Guitar-Sound-Processing/GSP/README.md

# <div align="center">[GSP](https://github.com/Guitar-Sound-Processing/GSP/wiki)</div>

## <div align="center">[Multi Effect Guitar Sound Processing](https://github.com/Guitar-Sound-Processing/GSP/wiki)</div>

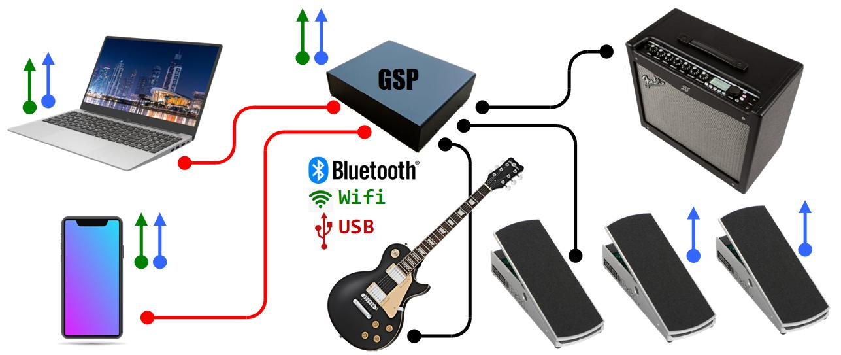
[picture p1: resources/gsp_periph.jpg]
GSP Peripherals
