Guitar-Sound-Processing/GSP/hardware/DriverBoard.md

# Driver Board

The Driver Board (DB) provides audio signal conditioning to the Analogue to Digital Convertion (ADC) of Daisy Seed board. Additionally DB perform filtering and amplification of Daisy's audio output that comes from Digital to Analogue Convertion (DAC). 
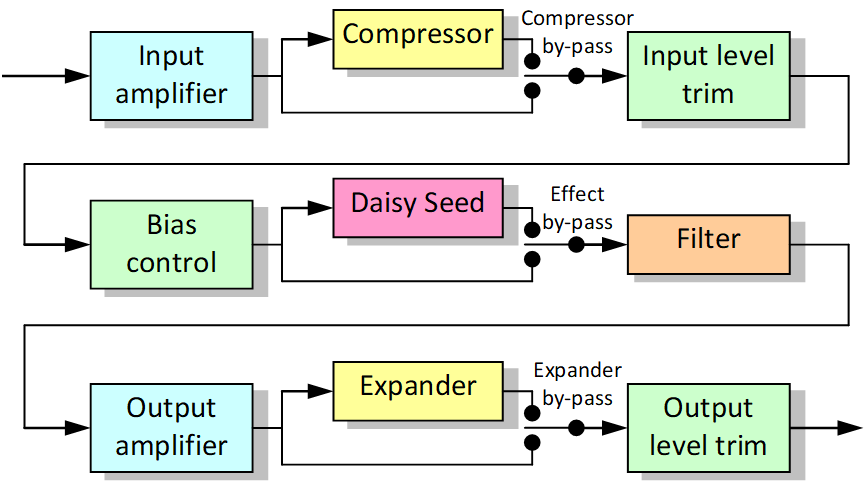
[picture p2: resources/driver_board_1.png]
Driver Board


The major components of the Driver Board are, as shown in the figure above:

- a quadruple operation amplifier LM324 for signal conditioning and amplification
- an analogue Compressor and Expander NE570
- 3 hadware switches to bypass the compressor, expander and Daisy Seed board
- 6 trimpot potentiometers to adjust the input level, Compressor output level, ADC input level, DAC output level, Expander output level, and GSP output level

The Driver Board has a quadruple operation amplifier LM324 to amplify the input signal from guitar at approximately 1V maximum amplitude up to 3.5V (biased at +4.5V) for compressor input, using the input level trimpot T1 (see figure below) measured at test point P1. A sine wave signal of 1V amplitude at 440 Hz can be used at input port to trim the potentiometers. The amplitude of the compressor output shall be adjusted by the Compressor output trimpot (T2) so as to have the same level of its input signal (3.5V) at test point P2. Then the signal is biased to +1.6V and to 1.6V amplitude (0 to 3.2V) at P3 using the ADC input trimpot (T3). After being digitally processed by the [Daisy Seed Shield](https://github.com/Guitar-Sound-Processing/GSP/blob/main/hardware/DS_board.md), the analogue signal returns to the Driver Board and pass to a second order low pass filter. It is then biased again to +4.5V and amplified to 3.5V at P4 by the DAC output trimmer (T4) before entering in to the Expander. The output amplitude of the Expander shall be adjusted by the Expander trimpot (T5) so as to be equal to its input level (3.5V) at P5. Finally the DC level is removed from the output signal and amplified by the output level trimpot (T6), just to have the same level of the guitar input signal (1V amplitude) at test point P6. The testing terminals P1...P6 shown in figure below shall be used to check the signal wave and to measure its amplitude. Picture below shows also the Compressor bypass switch (S1), Daisy Seed bypass (S2) and Expander bypass switch (S3)

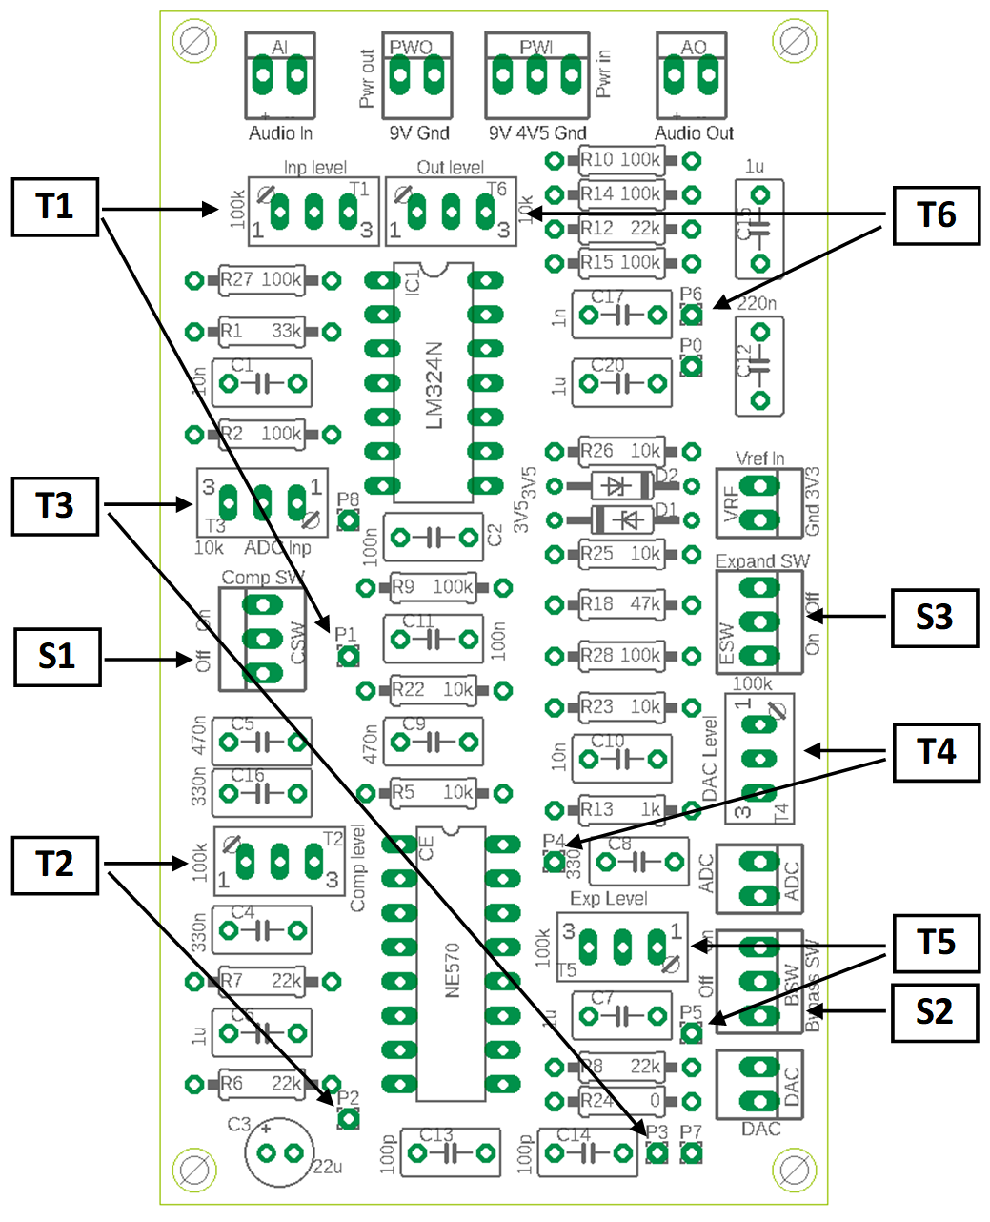
[picture p3: resources/driver_trim.png]
Driver Board PCB


DB was designed using the free version of Autodesk Eagle. Future versions will be based on Kicad. Moreover the board was conceived so as to avoid SMD components, to make it easy to populate by DIY users. The schematics and PCB layout are [available to download](https://github.com/Guitar-Sound-Processing/GSP/blob/main/resources/gsp_drv_v3.zip) as well as the board layout in Eagle files. For those that prefer Kicad instead of Eagle, is worth to mention that Kicad easily opens and converts Eagle files.

**Important notes:**

  1) Diodes D1 and D2 are protection diodes. They are NOT really required and can distort the audio signal. Please ignore these diodes unless you feel unsecured.
  2) Resistor R24 is just a jumper (0 Ohm). It gives more flexibility in case the output of the Expander does not reach the desired voltage.

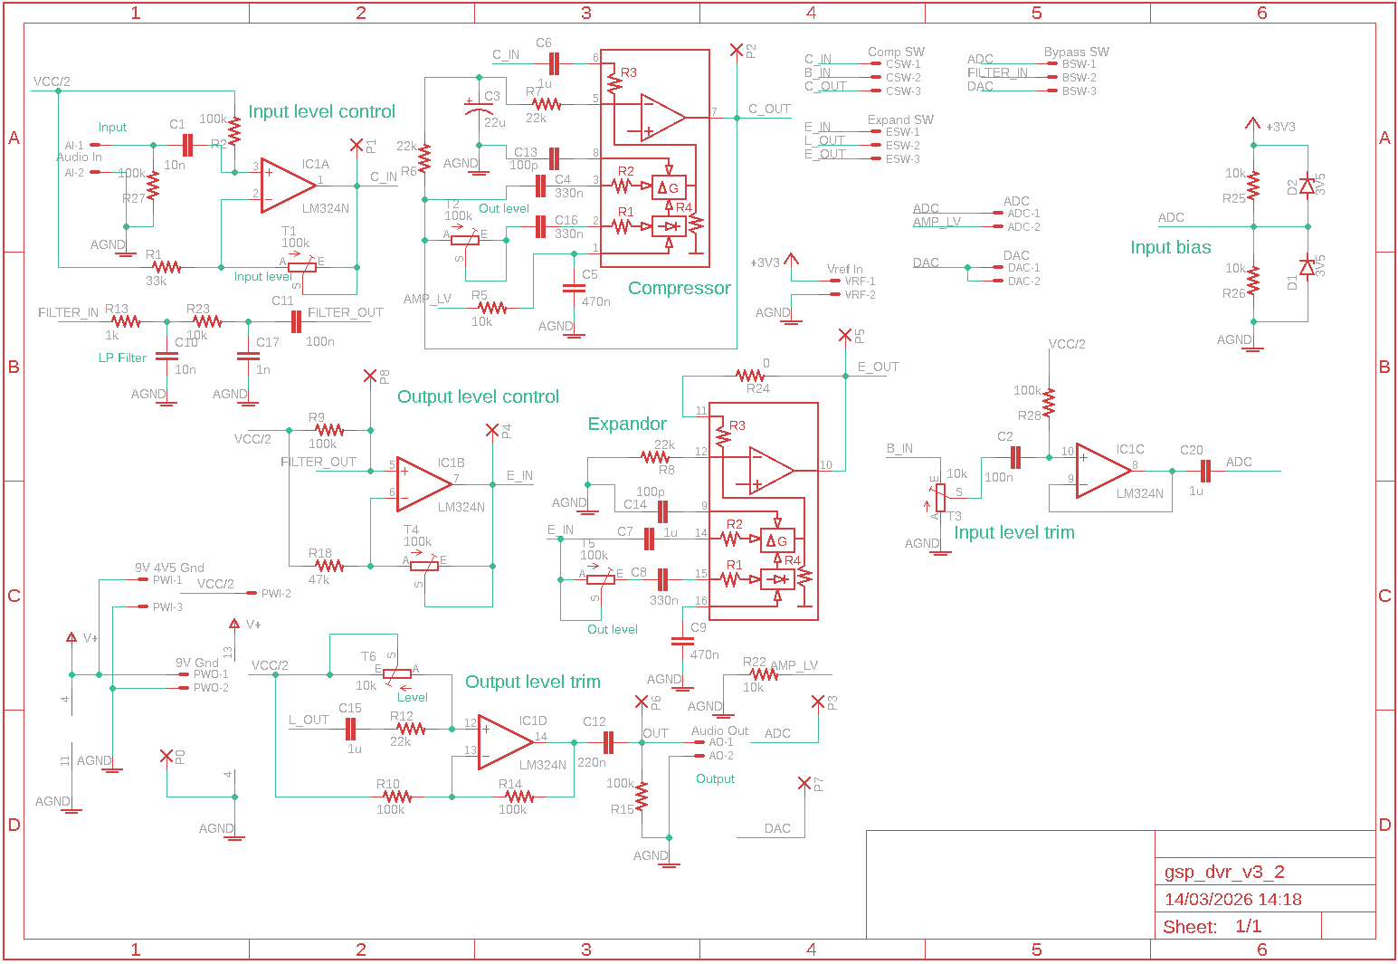
[picture p4: resources/driver_board_sch.png]
Driver Board SCH
