Guitar-Sound-Processing/GSP/hardware/ESP32_shield.md

# ESP32 Shield

The current version of GSP uses a ESP32 Wrover as External Device. To integrate the Wrover board to GSP, a dedicated pcb shield was designed to provide standard interfaces to Expression Pedals and Serial UART lines to Daisy Seed. Moreover, some jumpers are provided to interface the ESP32 Shield to a nRF24L01 wireless module for remote Expression Pedals. The Shield board does not contain any direct wiring to peripherics. All connections shall be manually provided by jumpers. This allow flexibility to change the Wrover (or any other compatible ESP32 board) pins to the desired data and power lines. The main characteristics of the board are:

- One JST PH header for 5V ESP32 input power line.
- Two 4 pin sockets to connect ESP32 to nRF24L01 module with air jumpers.
- A JST PH header for 3V3 and ground output to support magnetic isolator module
- Two JST PH 4 pin headers for Expression Pedal connection with Plug and Play capability.
- Two JST PH 2 pin headers to provide Serial lines to [Daisy Seed Shield](https://github.com/Guitar-Sound-Processing/GSP/blob/main/hardware/DS_board.md).
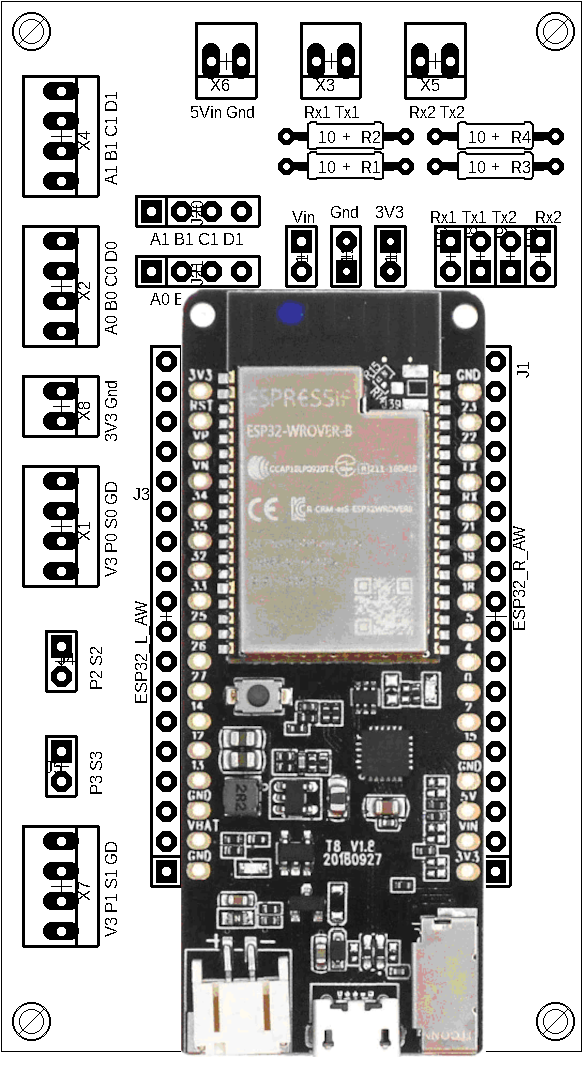
[picture p11: resources/ESP32_board.png]
ESP32 Board


Some of these connectors are already connected to the ESP32 pins, although they need jumpers to enable connection. They are:

 - Vin jumper connects the 5Vin (input power) to ESP32 VIN pin.
 - Gnd jumper joins the input ground from 5Vin input power to ESP32 Wrover ground pins, besides grounding both Expression Pedal headers and the ground pin of 3V3 output header.
 - 3V3 jumper enables the connection between the 3V3 output from ESP32 to the Expression Pedal headers and the 3V3 output connector for magnetic isolator module.
 - Tx1, Rx1, Tx2 and Rx2 jumpers to connect the JST headers for Serial lines to ESP32 pins: Tx1-GPIO23, Rx1-GPIO22, Tx2-GPIO19, Rx2-GPIO18.

In normal situation all these jumpers shall be wired. The ESP32 Wrover TIGO module has 34 pins (2x17). However the board has 36 (2x18) pins, as can be seen in figure above, since it is difficult to find female headers with 17 pins. So care must be taken in order to avoid placing the Wrover module in the wrong pins. 

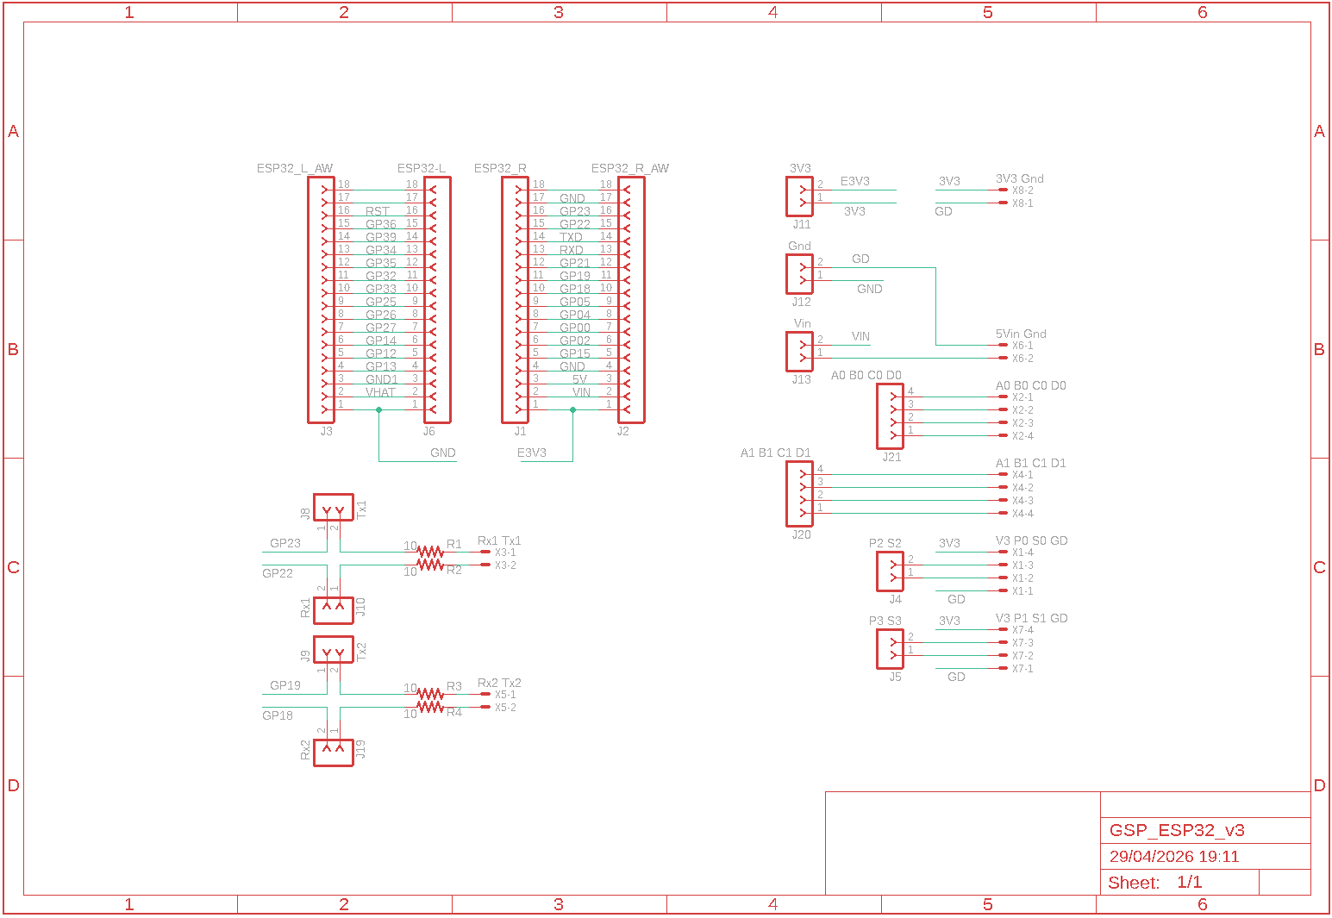
[picture p12: resources/ESP32_shield.png]
ESP32 Board schematics


The PCB was designed with Autodesk Eagle, but next version will be based on Kicad. The Eagle files for schematics and boards are available [here](https://raw.githubusercontent.com/Guitar-Sound-Processing/GSP/master/resources/ESP32_shield.zip).
