Guitar-Sound-Processing/GSP/hardware/GSP_boards.md

# GSP Boards

Current GSP version comprises four small pcb boards:

- [Daisy Seed Shield](https://github.com/Guitar-Sound-Processing/GSP/blob/main/hardware/DS_board.md)
- [Driver Board](https://github.com/Guitar-Sound-Processing/GSP/blob/main/hardware/DriverBoard.md)
- [ESP32 Shield](https://github.com/Guitar-Sound-Processing/GSP/blob/main/hardware/ESP32_shield.md)
- [Input and Output Board](https://github.com/Guitar-Sound-Processing/GSP/blob/main/hardware/IOBoard.md)

All boards have the same footprint, of 50 x 90 mm, which are cheaper to produce. They can be easily stacked, although they don't have stacking headers; only JST PH 2.0 Plug 2.0mm pitch headers to provide electrical interface between boards. They also have only pass through holes, without any SMD components (this may change in future versions).

The boards were designed with 1 mm width wiring, 2 layers (Bottom and Up) and no vias. That makes it easy to hand made all boards.

Daisy Seed Shield (DSS) provides a double header to stack the Daisy Seed board, besides a small DC/DC converter for 5V output to DS and ESP32 boards, together with JST headers for input and output audio signal.

The Audio Driver Board (ADB) amplifies the analogue input audio signal and compress it before delivering the signal to DSS. This board also filters and expand the analogue DSS output audio from DSS.

ESP32 Shield (ESPS) has a double header for ESP32 Wrover Lilygo TTGO board with SD Card support. It's main task is to provide high level user interface with DSS together with Expression Pedal interface. The board also provides a socket to a nRF24L01 board connection and JST headers to up to four Expression Pedals.

Finally the Input and Output Board (IOB) has 1/4 inch input and output guitar jacks, and one stereo jack for Expression Pedal.
