Guitar-Sound-Processing/GSP/gsp_daisy/Effects.md

# Effect Commands

Effect Commands are the way GSP uses to change the configuration parameters of any effect.

## Effect Command format

Any Effect Command must obey the following format:

*efc* [([+][-]*c*)] […[[[[*s*] *p*<sub>1</sub>] *p*<sub>2</sub>] *p*<sub>3</sub>]…]

in which:

-	*efc* stands for the three-characters effect name, like ```ovd``` (for Overdrive), ```tml``` (for Tremolo) and ```phr``` (for Phaser).
-	*p*<sub>1</sub>, *p*<sub>2</sub>, … *p*<sub>*n*</sub> are numeric parameters
-	[.] – A variable under brackets means it is optional. The brackets must be omitted on commands
-	(*c*) – A number under parenthesis in the command means a desired effect position in chain, or the current effect position in chain on GSP reply. *c* allows changing the effect position in chain (from 0 up to number_effects) and must follow the effect name after a separation (blank) character. The chain position parameter *c* is optional, but if present the parenthesis are necessary to differentiate from the remaining parameters.
-	*s* – The *s* parameter is the effect switch. It can be 0 (OFF, or by-pass) or 1 (ON)
-	*s*, *p*<sub>1</sub>, *p*<sub>2</sub>, *p*<sub>3</sub> … are optional, but if *p*<sub>3</sub> has to be changed, then *s*, *p*<sub>1</sub> and *p*<sub>2</sub> must also be defined in the command.
-	Each parameter *p*<sub>*i*</sub> can be separated with blank (space character), “,” or “;”. Example: *efc* (*c*), *s* *p*<sub>1</sub>, *p*<sub>2</sub>; *p*<sub>3</sub>. Additional blank characters are ignored.

Whenever the GSP Command Decoder detects a non valid or a non expected character in command line it discards the command and answers with “?” in console. For example:

```ovf 1 0.5```
> ```->?```</br>

since ```“ovf”``` isn’t a valid command.

## Position parameter

1. For any effect already in chain, the (*c*) parameter in Effect Command swaps the effect *efc* with the one in c position. 
2. If the effect isn’t already in chain, the (*c*) parameter inserts the effect on the slot pointed by *c*, and shifts the remaining effects to right. 
3. If *c* is greater than the position of the last effect in chain, the effect will be appended at the chain output. 
4. If *c* is negative then the absolute value is disregarded and the effect will be removed from chain. The remaining effects in chain are shifted to left to fulfill the blank position.
5. if *c* is ommited (but not the parenthesis) or if it is just a plus sign ```(+)``` the effect will be positioned at entrance. 

## <h2 id="efcswitch">Switch parameter

The *s* Switch parameter indicates the activation or deactivation (by-pass) of the selected effect, such that 0 (zero) means by-pass and 1 (one) means effect activation. The by-pass switch does not remove the effect from chain, but it remains disabled at the same chain position.

## Parameter range

Each parameter *p*<sub>*n*</sub> of any effect has its own maximum and minimum allowable values. Sending a command with no parameters, like ```ovd```, produces a printout of the current effect parameters as well as the maximum and minimum allowable values. Any parameter above the maximum or below the minimum will be internally clipped respectively to maximum or minimum. 

## Configuration Commands

Any effect can be configured by a three-character command and their parameters. The configuration commands are explained below, as well as their default parameters. Deep explanation on the effect parameters can be found in specific effect documentation that can be found in the [Available Effects section](https://github.com/Guitar-Sound-Processing/GSP/blob/main/gsp_daisy/Commands.md#avlefc). Current effects on GSP comprise

- [Level Detector (lvd)](#efclvd)
- [Chorus (chs)](#efcchs)
- [Compressor (cmp)](#efccmp)
- [Delay Feedback (dfb)](#efcdfb)
- [Delay Feedforward (dff)](#efcdff)
- [Detune (dtn)](#efcdtn)
- [Echo Feedback (efb)](#efcefb)
- [Echo Feedforward (eff)](#efceff)
- [Equalizer (eqz)](#efceqz)
- [Limiter (lim)](#efclim)
- [Noise Gate (ngt)](#efcngt)
- [Octave (oct)](#efcoct)
- [Overdrive (ovd)](#efcovd)
- [Phaser (phr)](#efcphr)
- [Pitch Shifter (sft)](#efcsft)
- [Reverb (rvb)](#efcrvb)
- [Tremolo (tml)](#efctml)
- [Vibrato (vbt)](#efcvbt)
- [Volume (vol)](#efcvol)
- [Wah Wah (wah)](#efcwah)

See also [Command Examples](#efcexp) section and the [Quick Reference Table](#efqrt)

### <h3 id="efclvd">Level Detector:</h3>

The Level Detector is not an “effect” but it is necessary for other effects. It is always active. Therefore it doesn’t have the switch *s*. The Level Detector measures the level of the input audio signal to drive the [LFFG](https://github.com/Guitar-Sound-Processing/GSP/blob/main/gsp_daisy/LFFG.md) when configured in ```LFO_LEVEL``` or ```LFO_REVERSE_LEVEL```, and, therefore, ```lvd``` doesn’t change the audio signal. However, the attack and release parameters can be user configured. Since the Level Detector is the first effect on chain and can't be moved, its position in chain is always -1. Moreover, the switch parameter is also always switched on (*s* = 1), and can't be changed. In fact, the ```lvd``` command does not accept either the chain position *c* or the switch parameter *s*. See [LFFG](https://github.com/Guitar-Sound-Processing/GSP/blob/main/gsp_daisy/Effects/LFFG/LFFG.pdf) and [Level Detector](https://github.com/Guitar-Sound-Processing/GSP/blob/main/gsp_daisy/Effects/Level_Detector/Level_Detector.pdf)  specific documentation for more information.

	lvd atk_tm rel_tm
		rel_tm 		– Attack time (milliseconds)
		rel_tm		– Release time (milliseconds)

Default:

> ->LVD (-1): 1 Attack (0.2-)(ms):    1.000 | Release (0.2-)(ms): 1000.000

### <h3 id="efcchs">Chorus:</h3>

Duplicates the signal with changes in pitch drove by a [LFFG](https://github.com/Guitar-Sound-Processing/GSP/blob/main/gsp_daisy/LFFG.md) (or LFO)

	chs [([+][-]c)] s depth delay_ms mixer lfo.profile lfo.freq lfo.duty gain
		depth 		– Depth
		delay_ms 	– Delay (milliseconds)
		mixer 		– Mixer
		lfo.profile 	– LFFG Profile
		lfo.freq 	– LFFG Frequency (Hz) or Expression Pedal Channel for lfo.profile = 8 (LFO_EXTERNAL)
		lfo.duty	– LFFG Duty cycle or Expression Pedal Threshold for lfo.profile = 8 (LFO_EXTERNAL)
		gain 		– Gain

Default*:

> ->CHS (8): OFF(0)|ON(1) 0 | Depth (0.1-100)(ms): 5.0 | Delay (0-1000)(ms): 1.0 | Mixer (0-1): 0.500 | Profile: (0-10) 0 | Frequency (0.2-5)(Hz): 0.500 | Duty Cycle (0-100)(%): 50.0 | Gain (0-1): 1.000

*Note: The current version of libDaisy does not print the character "%" through USB, as signaled in Duty Cycle, although it is correctly sent by UART serial lines.

### <h3 id="efccmp">Compressor:</h3>

Reduces the gain for loud signals

 	cmp [([+][-]c)] s attack_ms release_ms gain_db threshold_db
		attack_ms 	– Attack time (milliseconds)
		release_ms 	– Release time (milliseconds)
		gain_db		– Gain in dB
		threshold_db 	– Threshold in dB

Default:

> ->CMP (0): OFF(0)|ON(1) 0 | Attack (20-2000)(ms): 10.0 | Release (20-2000)(ms): 1000.0 | Gain (0-80)(dB): 20 | Threshold (0-80)(dB): 40

### <h3 id="efcdfb">Delay Feedback:</h3>

Mixes the signal with several delayed and attenuated copies

 	dfb [([+][-]c)] s delay_ms decay_rate gain
		delay_ms 	– Delay (milliseconds)
		decay_rate 	– Decay rate
		gain 		– Gain

Default:

> ->DFB (11): OFF(0)|ON(1) 0 | Delay Time (0.2-100)(ms): 31.0 | Decay rate (0-0.95): 0.700 | Gain (0-1): 1.000

### <h3 id="efcdff">Delay Feedforward:</h3>

Mixes the signal with a given number of copies (maximum 8)

	dff [([+][-]c)] s delay_ms decay_rate repeats gain
		delay_ms 	– Delay (milliseconds)
		decay_rate 	– Decay rate
		repeats 	– Number of repeats
		gain 		– Gain

Default:

> ->DFF (13): OFF(0)|ON(1) 0 | Delay Time (0.2-100)(ms): 31.0 | Decay rate (0-1): 0.900 | Number of repeats (1-8): 4 | Gain (0-1): 1.000

### <h3 id="efcdtn">Detune:</h3>

Reduces the frequency of the input signal down to a half (inverse of Pitch Shifter)

	dtn [([+][-]c)] s detune mixer gain
		detune 		– Pitch (detune)
		mixer 		– Mixer
		gain 		– Gain

Default:

> ->DTN (5): OFF(0)|ON(1) 0 | Detune (down) (0-12): 5.000 | Mixer (0-1): 0.500 | Gain (0-1): 1.000

### <h3 id="efcefb">Echo Feedback:</h3>

Same as Delay Feedback but with large time delays

	efb [([+][-]c)] s delay_ms decay_rate gain
		delay_ms 	– Delay (milliseconds)
		decay_rate 	– Decay rate
		gain 		– Gain

Default:

> ->EFB (12): OFF(0)|ON(1) 0 | Delay Time (50-)(ms): 1000.0 | Decay rate (0-0.95): 0.700 | Gain (0-1): 1.000

### <h3 id="efceff">Echo Feedforward:</h3>

Same as Delay Feedforward but with large time delays

	eff [([+][-]c)] s delay_ms decay_rate repeats gain
		delay_ms 	– Delay (milliseconds)
		decay_rate 	– Decay rate
		repeats 	– Number of repeats
		gain 		– Gain

Default:

> ->EFF (14): OFF(0)|ON(1) 0 | Delay Time (50-)(ms): 1000.0 | Decay rate (0-1): 0.900 | Number of repeats (1-8): 4 | Gain (0-1): 1.000

### <h3 id="efceqz">Equalizer:</h3>

Three band equalizer with frequency adjustment

	eqz [([+][-]c)] s g_low g_mean g_high f_low f_high
		g_low 		– Low frequency gain
		g_mean 		– Medium frequency gain
		g_high 		– High frequency gain
		f_low 		– Low frequency cutoff
		f_high 		– High frequency cutoff

Default:

> ->EQZ (7): OFF(0)|ON(1) 0 | Gains (0-1): Low 1.000 , Medium  1.000 , High 1.000 | Cutoff frequencies (Hz): Low (200-) 200.000 , High (-2000) 800.0

### <h3 id="efclim">Limiter: </h3>

It applies a soft amplitude clipping, to avoid signal distortion

	lim [([+][-]c)] s smooth input_gain
		smooth 		– Smoothness
		input_gain 	– Input gain

Default:

> ->LIM (17): OFF(0)|ON(1) 0 | Smooth factor (0-1): 1.000 | Gain (0- ): 1.000

### <h3 id="efcngt">Noise Gate:</h3>

Mutes the output of low level signals

	ngt [([+][-]c)] s atk_tm rel_tm gain threshold
		rel_tm 		– Attack time (milliseconds)
		rel_tm		– Release time (milliseconds)
		gain		– Output gain
		threshold	– Output threshold

Default:

> ->NGT (18): OFF(0)|ON(1) 0 | Attack (20-2000)(ms): 10.0 | Release (20-2000)(ms): 1000.0 | Gain (0.1-1): 1.000 | Threshold (0-1): 0.100

### <h3 id="efcoct">Octave:</h3>

Doubles the signal frequency and mixes it with input

	oct [([+][-]c)] s mixer gain
		mixer 		– Mixer
		gain 		– Gain

Default:

> ->OCT (3): OFF(0)|ON(1) 0 | Mixer (0-1): 0.500 | Gain (0-1): 1.000

### <h3 id="efcovd">Overdrive:</h3>

Applies a hard clipping on the signal (distortion)

	ovd [([+][-]c)] s sustain tone gain
		sustain 	– Sustain
		tone 		– Tone
		mixer		– Mixer
		gain 		– Output gain

Default:

> ->OVD (1): OFF(0)|ON(1) 0 | Sustain (0.1-1): 0.500 | Tone (0-1): 0.800 | Mixer (0-1): 1.000 | Gain (0-1): 1.000

### <h3 id="efcphr">Phaser:</h3>

Mixes the signal with an out of phase copy drove by a [LFFG](https://github.com/Guitar-Sound-Processing/GSP/blob/main/gsp_daisy/LFFG.md)

	phr [([+][-]c)] s depth level lfo.profile lfo.freq lfo.duty gain
		depth 		– Depth
		level 		– Level
		lfo.freq 	– LFFG Frequency (Hz) or Expression Pedal Channel for lfo.profile = 8 (LFO_EXTERNAL)
		lfo.duty	– LFFG Duty cycle or Expression Pedal Threshold for lfo.profile = 8 (LFO_EXTERNAL)
		lfo.duty	– LFFG Duty cycle
		gain 		– Gain

Default*:

> ->PHR (2): OFF(0)|ON(1) 0 | Depth (0-1): 0.500 | Level (0-1000): 10.0 | Profile: (0-10) 0 | Frequency (0.2-5)(Hz): 0.250 | Duty Cycle (0-100)(%): 50.0 | Gain (0-1): 1.000

Note: The current version of libDaisy does not print the character "%" through USB, as signaled in Duty Cycle, although it is correctly sent by UART serial lines.

### <h3 id="efcsft">Pitch Shifter:</h3>

Increases the frequency of the input signal continously up to double (Inverse of Detune)

	sft [([+][-]c)] s pshift mixer gain
		pshift 		– Pitch (shift)
		mixer 		– Mixer
		gain 		– Gain

Default:

> ->SFT (4): OFF(0)|ON(1) 0 | Shift (up) (0-12): 5.000 | Mixer (0-1): 0.500 | Gain (0-1): 1.000

### <h3 id="efcrvb">Reverb:</h3>

Mimics the reverberation of a large room

	rvb [([+][-]c)] s rvbtime_time gain
		rvbtime_time 	– Reverber time
		gain 		– Gain

Default:

> ->RVB (10): OFF(0)|ON(1) 0 | Reverber Time (0-20000)(ms): 1000.0 | Gain (0-1): 1.000

### <h3 id="efctml">Tremolo:</h3>

Changes the input amplitude with a [LFFG](https://github.com/Guitar-Sound-Processing/GSP/blob/main/gsp_daisy/LFFG.md) 

	tml [([+][-]c)] s lfo.profile lfo.freq lfo.duty gain
		lfo.profile 	– LFFG Profile
		lfo.freq 	– LFFG Frequency (Hz) or Expression Pedal Channel for lfo.profile = 8 (LFO_EXTERNAL)
		lfo.duty	– LFFG Duty cycle or Expression Pedal Threshold for lfo.profile = 8 (LFO_EXTERNAL)
		gain 		– Gain

Default*:

> ->TML (15): OFF(0)|ON(1) 0 | Profile: (0-10) 1 | Frequency (0.2-5)(Hz): 2.000 | Duty Cycle (0-100)(%): 50.0 | Gain (0-1): 1.000

*Note: The current version of libDaisy does not print the character "%" through USB, as signaled in Duty Cycle, although it is correctly sent by UART serial lines.

### <h3 id="efcvbt">Vibrato:</h3>

Changes the input frequency with a [LFFG](https://github.com/Guitar-Sound-Processing/GSP/blob/main/gsp_daisy/LFFG.md) 

	vbt [([+][-]c)] s depth delay_ms lfo.profile lfo.freq lfo.duty gain
		depth 		– Depth
		delay_ms 	– Delay (milliseconds)
		lfo.profile 	– LFFG Profile
		lfo.freq 	– LFFG Frequency (Hz) or Expression Pedal Channel for lfo.profile = 8 (LFO_EXTERNAL)
		lfo.duty	– LFFG Duty cycle or Expression Pedal Threshold for lfo.profile = 8 (LFO_EXTERNAL)
		gain 		– Gain

Default:

> ->VBT (9): OFF(0)|ON(1) 0 | Depth (0.1-100)(ms): 5.0 | Delay (0-1000)(ms): 1.0 | Profile: (0-10) 0 | Frequency (0.2-5)(Hz): 0.500 | Duty Cycle (0-100)(%): 50.0 | Gain (0-1): 1.000

*Note: The current version of libDaisy does not print the character "%" through USB, as signaled in Duty Cycle, although it is correctly sent by UART serial lines.

### <h3 id="efcvol">Volume:</h3>

Changes the input level based on a [LFFG](https://github.com/Guitar-Sound-Processing/GSP/blob/main/gsp_daisy/LFFG.md) with external (potentiometer) signal

	vol [([+][-]c)] s lfo.profile lfo.freq lfo.duty gain
		lfo.profile 	– LFFG Profile
		lfo.freq 	– LFFG Frequency (Hz) or Expression Pedal Channel for lfo.profile = 8 (LFO_EXTERNAL)
		lfo.duty	– LFFG Duty cycle or Expression Pedal Threshold for lfo.profile = 8 (LFO_EXTERNAL)
		gain 		– Gain

Default*:

> ->VOL (16): OFF(0)|ON(1) 0 | Profile: (0-10) 1 | Frequency (0.2-5)(Hz): 2.000 | Duty Cycle (0-100)(%): 50.0 | Gain (0-1): 1.000

*Note: The current version of libDaisy does not print the character "%" through USB, as signaled in Duty Cycle, although it is correctly sent by UART serial lines.

### <h3 id="efcwah">Wah Wha:</h3>

Modifies the tone of the input signal driven by a [LFFG](https://github.com/Guitar-Sound-Processing/GSP/blob/main/gsp_daisy/LFFG.md)

	wah [([+][-]c)] s lfo.profile lfo.freq lfo.duty gain
		lfo.profile 	– LFFG Profile
		lfo.freq 	– LFFG Frequency (Hz) or Expression Pedal Channel for lfo.profile = 8 (LFO_EXTERNAL)
		lfo.duty	– LFFG Duty cycle or Expression Pedal Threshold for lfo.profile = 8 (LFO_EXTERNAL)
		gain 		– Gain 

Default*:

> ->WAH (6): OFF(0)|ON(1) 0 | Profile: (0-10) 1 | Frequency (0.2-5)(Hz): 2.000 | Duty Cycle (0-100)(%): 50.0 | Gain (0-1): 1.000

*Note: The current version of libDaisy does not print the character "%" through USB, as signaled in Duty Cycle, although it is correctly sent by UART serial lines.

## <h3 id="efcexp">Effect Command Examples</h3>

```ovd```
> ->OVD (1): OFF(0)|ON(1) 0 | Sustain (0.1-1): 0.500 | Tone (0-1): 0.800 | Mixer (0-1): 1.000 | Gain (0-1): 1.000

```all```
> ->Inp->(LVD)->CMP->OVD->PHR->OCT->SFT->DTN->WAH->EQZ->CHS->VBT->RVB->DFB->EFB->DFF->EFF->TML->VOL->LIM->NGT->Out->

```phr (5)```
> ->PHR (5): OFF(0)|ON(1) 0 | Depth (0-1): 0.500 | Level (0-1000): 10.0 | Profile: (0-10) 0 | Frequency (0.2-5)(Hz): 0.250 | Duty Cycle (0-100)(): 50.0 | Gain (0-1): 1.000

```all```
> ->Inp->(LVD)->CMP->OVD->OCT->SFT->DTN->PHR->WAH->EQZ->CHS->VBT->RVB->DFB->EFB->DFF->EFF->TML->VOL->LIM->NGT->Out->

```tml (-1)```
> ->TML (-1): OFF(0)|ON(1) 0 | Profile: (0-10) 1 | Frequency (0.2-5)(Hz): 2.000 | Duty Cycle (0-100)(): 50.0 | Gain (0-1): 1.000

```all```
> ->Inp->(LVD)->CMP->OVD->OCT->SFT->DTN->PHR->WAH->EQZ->CHS->VBT->RVB->DFB->EFB->DFF->EFF->VOL->LIM->NGT->Out->
 
```eqz (+)```
> ->EQZ (0): OFF(0)|ON(1) 0 | Gains (0-1): Low 1.000 , Medium  1.000 , High 1.000 | Cutoff frequencies (Hz): Low (200-) 200.000 , High (-2000) 800.0

```all```
> ->Inp->EQZ->CMP->OVD->OCT->SFT->DTN->PHR->WAH->CHS->VBT->RVB->DFB->EFB->DFF->EFF->VOL->LIM->NGT->Out->

```dfb```
> ->DFB (11): OFF(0)|ON(1) 0 | Delay Time (0.2-100)(ms): 31.0 | Decay rate (0-0.95): 0.700 | Gain (0-1): 1.000

```dfb 1 22 0.8```
> ->DFB (11): OFF(0)|ON(1) 1 | Delay Time (0.2-100)(ms): 22.0 | Decay rate (0-0.95): 0.800 | Gain (0-1): 1.000

```vbt```
> ->VBT (9): OFF(0)|ON(1) 0 | Depth (0.1-100)(ms): 5.0 | Delay (0-1000)(ms): 1.0 | Profile: (0-10) 0 | Frequency (0.2-5)(Hz): 0.500 | Duty Cycle (0-100)(): 50.0 | Gain (0-1): 1.000

```vbt 1 10 1 5```
> ->VBT (9): OFF(0)|ON(1) 1 | Depth (0.1-100)(ms): 10.0 | Delay (0-1000)(ms): 1.0 | Profile: (0-10) 5 | Frequency (0.2-5)(Hz): 0.500 | Duty Cycle (0-100)(): 50.0 | Gain (0-1): 1.000

##  <h2 id="efqrt">Quick Reference Table </h2>

| Effect	| Parameter | Minimum | Maximum | Units | Default | Type |
| --- | --- | :---: | :---: | :---: | :---: | :---: |
| LVD | Attack | 0.2 | - | ms | 1.0 | float | 
| | Release | 0.2 | - | ms | 1000.0 | float |
| CHS (8): | Depth | 0.1 | 100 | ms | 5.0 | float |
| | Delay | 0.0 | 1000.0 | ms | 1.0 | float |
| | Mixer | 0.0 | 1.0 | - | 0.5 | float | 
| | Profile | 0 | 10 | - | 0 | int |
| | Frequency/Channel | 0.2/0 | 5.0/7 | Hz/ | 0.500/ | float/int |
| | Duty Cycle/Threshold | 0.0 | 100.0 | % | 50.0 | float |
| | Gain | 0.0 | 1.0 | - | 1.000 | float |
| CMP (0): | Attack | 20.0 | 2000.0 | ms | 10.0 | float |
| |Release | 20.0 | 2000.0 | ms | 1000.0 | float |
| | Gain | 0 | 80 | dB | 20 | int |
| | Threshold | 0 | 80 | dB | 40 | int |
| DFB (11): | Delay Time | 0.2 | 100 | ms | 31.0 | float |
| | Decay rate | 0.0 | 0.95 | - | 0.700 | float |
| | Gain | 0.0 | 1.0 | - | 1.000 | float |
| DFF (13): | Delay Time | 0.2 | 100 | ms | 31.0 | float |
| | Decay rate | 0.0 | 1.0 | - | 0.900 | float |
| | Number of repeats | 1 | 8 | - | 4 | int |
| | Gain | 0.0 | 1.0 | - | 1.000 | float |
| DTN (5): | Detune (down) | 0.0 | 12 | interval | 5.000 | float |
| | Mixer | 0.0 | 1.0 | - | 0.500 | float |
| | Gain | 0.0 | 1.0 | - | 1.000 | float |
| EFB (12): | Delay Time | 50 | - | ms | 1000.0 | float |
| | Decay rate | 0.0 | 0.95 | - | 0.700 | float |
| | Gain | 0.0 | 1.0 | - | 1.000 | float |
| EFF (14): | Delay Time | 50.0 | - | ms | 1000.0 | float |
| | Decay rate | 0.0 | 1.0 | - | 0.900 | float |
| | Number of repeats | 1 | 8 | - | 4 | int |
| | Gain | 0.0 | 1.0 | - | 1.000 | float |
| EQZ (7):  | Low Gain | 0.0 | 1.0 | - | 1.000 | float |
| | Medium Gain | 0.0 | 1.0 | - | 1.000 | float |
| | High Gain | 0.0 | 1.0 | - | 1.000 | float |
| | Low Cut Freq | 200 | HCF | Hz | 200.000 | float |
| | High Cut Freq | LCF | 2000 | Hz | 800.0 | float |
| LIM (17):  | Smooth factor | 0.0 | 1.0 | - | 1.000 | float |
| | Gain | 0.0 | 1.0 | - | 1.000 | float |
| NGT (18): | Attack | 20.0 | 2000.0 | ms | 10.0 | float |
| | Release | 20.0 | 2000.0 | ms | 1000.0 | float |
| | Gain | 0.1 | 1.0 | - | 1.000 | float |
| | Threshold | 0.0 | 1.0 | - | 0.100 | float |
| OCT (3):  | Mixer | 0.0 | 1.0 | - | 0.500 | float |
| | Gain | 0.0 | 1.0 | - | 1.000 | float |
| OVD (1):  | Sustain | 0.1 | 1.0 | - | 0.500 | float |
| | Tone | 0.0 | 1.0 | - | 0.800 | float |
| | Mixer | 0.0 | 1.0 | - | 1.000 | float |
| | Gain | 0.0 | 1.0 | - | 1.000 | float |
| PHR (2):  | Depth | 0.0 | 1.0 | - | 0.500 | float |
| | Level | 0.0 | 1000.0 | - | 10.0 | float |
| | Profile | 0 | 10 | - | 0 | int |
| | Frequency/Channel | 0.2/0 | 5.0/7 | Hz/ | 0.500/ | float/int |
| | Duty Cycle/Threshold | 0.0 | 100.0 | % | 50.0 | float |
| | Gain | 0.0 | 1.0 | - | 1.000 | float |
| SFT (4):  | Shift (up) | 0.0 | 12 | interval | 5.000 | float |
| | Mixer | 0.0 | 1.0 | - | 0.500 | float |
| | Gain | 0.0 | 1.0 | - | 1.000 | float |
| RVB (10):  | Reverber Time | 0.0 | 20000.0 | ms | 1000.0 | float |
| | Gain | 0.0 | 1.0 | - | 1.000 | float |
| TML (15): | Profile | 0 | 10 | - | 1 | int |
| | Frequency/Channel | 0.2/0 | 5.0/7 | Hz/ | 0.500/ | float/int |
| | Duty Cycle/Threshold | 0.0 | 100.0 | % | 50.0 | float |
| | Gain | 0.0 | 1.0 | - | 1.000 | float |
| VBT (9): | Depth | 0.1 | 100.0 | ms | 5.0 | float |
| | Delay | 0.0 | 1000.0 | ms | 1.0 | float |
| | Profile | 0 | 10 | - | 0 | int |
| | Frequency/Channel | 0.2/0 | 5.0/7 | Hz/ | 0.500/ | float/int |
| | Duty Cycle/Threshold | 0.0 | 100.0 | % | 50.0 | float |
| | Gain | 0.0 | 1.0 | - | 1.000 | float |
| VOL (16): | Profile | 0 | 10 | - | 1 | int |
| | Frequency/Channel | 0.2/0 | 5.0/7 | Hz/ | 0.500/ | float/int |
| | Duty Cycle/Threshold | 0.0 | 100.0 | % | 50.0 | float |
| | Gain | 0.0 | 1.0 | - | 1.000 | float |
| WAH (6):  | Profile | 0 | 10 | - | 1 | int |
| | Frequency/Channel | 0.2/0 | 5.0/7 | Hz/ | 0.500/ | float/int |
| | Duty Cycle/Threshold | 0.0 | 100.0 | % | 50.0 | float |
| | Gain | 0.0 | 1.0 | - | 1.000 | float |
