Guitar-Sound-Processing/GSP/gsp_daisy/Commands.md

# GSP Command Decoder

## Description 

The Guitar Sound Processing is configured by interpreted commands by [Daisy Seed (DS)](https://electro-smith.com/products/daisy-seed), through UART serial interfaces or USB. There are commands to change the effects setup and the effect position in chain. More specificaly DS can accept commands to:

- change effect parameters,
- select and activate the effect in chain,
- configure and set the effect sequence on chain,
- link a given effect to an expression pedal.

On the other hand, the ED will be in charge to

- communicate with the application software to receive and retransmit commands through USB, Bluetooth or Wifi,
- read Volume or Expression pedals and send these data to DS

Therefore, from the Application point of view, the effect commands are interpreted by the Daisy Seed, while Expression Pedals are handled by the External Device. DS is then responsible to interpret a minimum set of commands, while the External Device provides interface with potentiometers of Expression Pedals. 

The complete list of configuration commands to GSP comprises

- [Effects commands](https://github.com/Guitar-Sound-Processing/GSP/blob/main/gsp_daisy/Effects.md)
- [Chain commands](https://github.com/Guitar-Sound-Processing/GSP/blob/main/gsp_daisy/Chain.md)
- [Interface commands](https://github.com/Guitar-Sound-Processing/GSP/blob/main/gsp_daisy/Interfaces.md)
- [Expression Pedal commands](https://github.com/Guitar-Sound-Processing/GSP/blob/main/gsp_daisy/ExprPedal.md)

All these commands are processed and interpreted by the Daisy Seed board. The External Device, like ESP32, acts also as passthrough device to send commands to DS through USB or Bluetooth. The effect modules are codified in C++ classes, and obey some guidelines described in

- [Effect Software Directives](https://github.com/Guitar-Sound-Processing/GSP/blob/main/gsp_daisy/SWDirectives.md#effect-software-directives)

## GSP Programming 

GSP is programmable through ASCII commands from available serial lines. Presently GSP monitors the USB (serial) and UART_1 serial line. Input commands from serial lines are interpreted and executed by internal GSP procedures. Commands to Daisy Seed shall terminate with standard ASCII control characters Carriage Return (CR - D13) or Line Feed (LF - D10). After receiving a command, the interpreter answers with knowledge prompt to the specific input device (USB or UART Serial). For instance, the input command:

```OVD```

is answered with:

> ```->OVD (1): OFF(0)|ON(1) 0 | Sustain (0.1-1): 0.500 | Tone (0-1): 0.800 | Mixer (0-1): 1.000 | Gain (0-1): 1.000```

GSP decoder is case insensitive, which means that ```oVD```, ```Ovd```, ```OvD``` and so on are all recognized as ```OVD```.

## <h3 id="avlefc">Available Effects:</h3>

Currently there are 19 available effects in GSP 1.0.0, besides a multi-purpose Low Frequency and Function Generator (LFFG) to provide low frequency audio modulation for several effects. The available effects are:

- [Chorus](https://github.com/Guitar-Sound-Processing/GSP/blob/main/gsp_daisy/Effects.md#efcchs) – ([doc](https://github.com/Guitar-Sound-Processing/GSP/blob/main/gsp_daisy/Effects/Chorus/Chorus.pdf)) - Mixes the input signal with a LFFG delayed copy.
- [Compressor](https://github.com/Guitar-Sound-Processing/GSP/blob/main/gsp_daisy/Effects.md#efccmp) – ([doc](https://github.com/Guitar-Sound-Processing/GSP/blob/main/gsp_daisy/Effects/Compressor/Compressor.pdf)) - Compress the input signal to increase the dynamic range.
- [Delay Feedback](https://github.com/Guitar-Sound-Processing/GSP/blob/main/gsp_daisy/Effects.md#efcdfb) – ([doc](https://github.com/Guitar-Sound-Processing/GSP/blob/main/gsp_daisy/Effects/Delay&Echo_FB/Delay&Echo_Feedback.pdf)) - Mixes the input signal with a feedback attenuated and delayed copy.
- [Delay Feedforward](https://github.com/Guitar-Sound-Processing/GSP/blob/main/gsp_daisy/Effects.md#efcdff) – ([doc](https://github.com/Guitar-Sound-Processing/GSP/blob/main/gsp_daisy/Effects/Delay&Echo_FF/Delay&Echo_Feedforward.pdf)) - Mixes the input signal with a fixed number of attenuated and delayed copies.
- [Detune](https://github.com/Guitar-Sound-Processing/GSP/blob/main/gsp_daisy/Effects.md#efcdtn) – ([doc](https://github.com/Guitar-Sound-Processing/GSP/blob/main/gsp_daisy/Effects/Detune/Octave-Detune-Pitch_Shifter.pdf)) - Decreases continuously the pitch, up to one octave below.
- [Echo Feedback](https://github.com/Guitar-Sound-Processing/GSP/blob/main/gsp_daisy/Effects.md#efcefb) – ([doc](https://github.com/Guitar-Sound-Processing/GSP/blob/main/gsp_daisy/Effects/Delay&Echo_FB/Delay&Echo_Feedback.pdf)) - Mixes the input signal with a feedback time delayed copy.
- [Echo Feedforward](https://github.com/Guitar-Sound-Processing/GSP/blob/main/gsp_daisy/Effects.md#efceff) – ([doc](https://github.com/Guitar-Sound-Processing/GSP/blob/main/gsp_daisy/Effects/Delay&Echo_FF/Delay&Echo_Feedforward.pdf)) - Mixes the input signal with a fixed number of attenuated and long time delayed copies.
- [Equalizer](https://github.com/Guitar-Sound-Processing/GSP/blob/main/gsp_daisy/Effects.md#efceqz) – ([doc](https://github.com/Guitar-Sound-Processing/GSP/blob/main/gsp_daisy/Effects/Equalizer/Equalizer.pdf)) - Three-band equalizer with adjustable frequencies.
- [Limiter](https://github.com/Guitar-Sound-Processing/GSP/blob/main/gsp_daisy/Effects.md#efclim) – ([doc](https://github.com/Guitar-Sound-Processing/GSP/blob/main/gsp_daisy/Effects/Limiter/Limiter.pdf)) - Applies a non-linear threshold on the input level.
- [Noise Gate](https://github.com/Guitar-Sound-Processing/GSP/blob/main/gsp_daisy/Effects.md#efcngt) – ([doc](https://github.com/Guitar-Sound-Processing/GSP/blob/main/gsp_daisy/Effects/Noise_Gate/Noise_Gate.pdf)) - Mutes the output signal when the input power falls below a given threshold.
- [Octave](https://github.com/Guitar-Sound-Processing/GSP/blob/main/gsp_daisy/Effects.md#efcoct) – ([doc](https://github.com/Guitar-Sound-Processing/GSP/blob/main/gsp_daisy/Effects/Detune/Octave-Detune-Pitch_Shifter.pdf)) - Increases the pitch by one octave (double frequency).
- [Overdrive](https://github.com/Guitar-Sound-Processing/GSP/blob/main/gsp_daisy/Effects.md#efcovd) – ([doc](https://github.com/Guitar-Sound-Processing/GSP/blob/main/gsp_daisy/Effects/Overdrive/Overdrive.pdf)) - Distortion based on Big Muff.
- [Phaser](https://github.com/Guitar-Sound-Processing/GSP/blob/main/gsp_daisy/Effects.md#efcphr) – ([doc](https://github.com/Guitar-Sound-Processing/GSP/blob/main/gsp_daisy/Effects/Phaser/Phaser.pdf)) - Mixes the input signal with an out-of-phase copy driven by a LFFG.
- [Pitch Shifter](https://github.com/Guitar-Sound-Processing/GSP/blob/main/gsp_daisy/Effects.md#efcsft) – ([doc](https://github.com/Guitar-Sound-Processing/GSP/blob/main/gsp_daisy/Effects/Detune/Octave-Detune-Pitch_Shifter.pdf)) - Increases continuously the pitch, up to one octave above.
- [Reverber](https://github.com/Guitar-Sound-Processing/GSP/blob/main/gsp_daisy/Effects.md#efcrvb) – ([doc](https://github.com/Guitar-Sound-Processing/GSP/blob/main/gsp_daisy/Effects/Reverber/Reverb.pdf)) - Simulates the sound of reverberation rooms.
- [Tremolo](https://github.com/Guitar-Sound-Processing/GSP/blob/main/gsp_daisy/Effects.md#efctml) – ([doc](https://github.com/Guitar-Sound-Processing/GSP/blob/main/gsp_daisy/Effects/Tremolo/Tremolo-Volume.pdf)) - Applies a LFFG envelop to the amplitude of the input signal.
- [Vibrato](https://github.com/Guitar-Sound-Processing/GSP/blob/main/gsp_daisy/Effects.md#efcvbt) – ([doc](https://github.com/Guitar-Sound-Processing/GSP/blob/main/gsp_daisy/Effects/Chorus/Vibrato.pdf)) - Produces a LFFG delayed signal that mimics a vibrato.
- [Volume](https://github.com/Guitar-Sound-Processing/GSP/blob/main/gsp_daisy/Effects.md#efcvol) – ([doc](https://github.com/Guitar-Sound-Processing/GSP/blob/main/gsp_daisy/Effects/Tremolo/Tremolo-Volume.pdf)) - Applies a LFFG to the input signal (same as Tremolo).
- [Wahwah](https://github.com/Guitar-Sound-Processing/GSP/blob/main/gsp_daisy/Effects.md#efcwah) – ([doc](https://github.com/Guitar-Sound-Processing/GSP/blob/main/gsp_daisy/Effects/Wah_Wah/Wah_Wah.pdf)) - Applies a BPF (Band Pass Filter) adjusted by a LFFG.

There is also a Level Detector which isn’t exactly an effect, but rather a user configurable level measurement of the input signal, before the signal is changed by any effect:

- [Level Detector](https://github.com/Guitar-Sound-Processing/GSP/blob/main/gsp_daisy/Effects.md#efclvd) – ([doc](https://github.com/Guitar-Sound-Processing/GSP/blob/main/gsp_daisy/Effects/Level_Detector/Level_Detector.pdf)) - Measures the level of the input signal. It can be used to drive the LFFG (Low Frequency Function Generator) when the selected envelop amplitude is LFO_LEVEL or LFO_REVERSE_LEVEL modes.

Besides these effects, a Tone_LPHP (Low-Pass High-Pass or Treble filter) class was developed for the Overdrive effect, but can be used in any future developments. Documentation of LPHP filter can be found in [Overdrive doc](https://github.com/Guitar-Sound-Processing/GSP/blob/main/gsp_daisy/Effects/Overdrive/Overdrive.pdf).

Some effects share the same code, but with different default parameters. They are:

- [Chorus](https://github.com/Guitar-Sound-Processing/GSP/blob/main/gsp_daisy/Effects.md#efcchs) and [Vibrato](https://github.com/Guitar-Sound-Processing/GSP/blob/main/gsp_daisy/Effects.md#efcvbt)
- [Delay Feedback](https://github.com/Guitar-Sound-Processing/GSP/blob/main/gsp_daisy/Effects.md#efcdfb) and [Echo Feedback](https://github.com/Guitar-Sound-Processing/GSP/blob/main/gsp_daisy/Effects.md#efcefb)
- [Delay Feedforward](https://github.com/Guitar-Sound-Processing/GSP/blob/main/gsp_daisy/Effects.md#efcdff) and [Echo Feedforward](https://github.com/Guitar-Sound-Processing/GSP/blob/main/gsp_daisy/Effects.md#efceff)
- [Tremolo](https://github.com/Guitar-Sound-Processing/GSP/blob/main/gsp_daisy/Effects.md#efctml) and [Volume](https://github.com/Guitar-Sound-Processing/GSP/blob/main/gsp_daisy/Effects.md#efcvol)

GSP software is composed by the effect algorithms and command interface modules. The algorithms are described on specific documentation for each effect (see 'doc' above).
