Guitar-Sound-Processing/GSP/ext_device/ESP32.md

# External Device

Although any microprocessor module can be used to bypass the effect commands to Daisy Seed, a ESP32 WROVER module was chosen by its capability to provide wifi 
and bluetooth support. Therefore GSP can be potentially configured by any smartphone or computer connected to ESP32. There are several ESP32 WROVER modules available on market. Among them the LILYGO or TTGO was selected, since it offers also SMD support for data storage.

<div align="center">
  
**LILYGO ESP32 WROVER Module**
</div>
<p align="center">
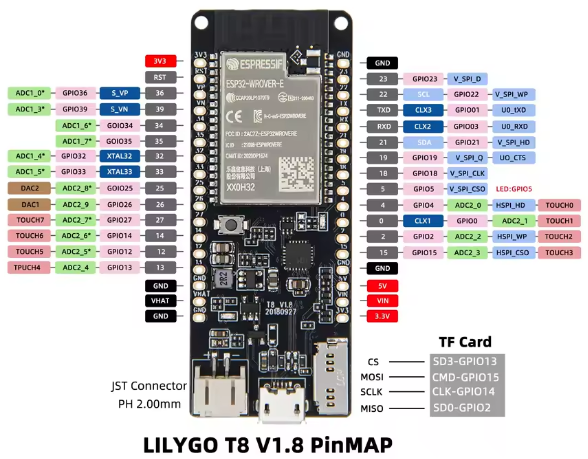
[picture p19: resources/esp32_ttgo.png]
ESP32 LILYGO
  
</p>

## ESP32 tasks

ESP32 WROVER has the following tasks:

- To receive, interpret and execute the [Expression Pedal](https://github.com/Guitar-Sound-Processing/GSP/blob/main/gsp_daisy/ExprPedal.md) commands (P, A, S and C) coming from DS through UART_1 Serial line.
- To receive the [Effect Commands](https://github.com/Guitar-Sound-Processing/GSP/blob/main/gsp_daisy/Commands.md)) from end users, and route then to Daisy Seed through UART_1 Serial line.
- To receive reply from Daisy Seed and to transmit them to GSP application in Android phones. 

From low to high level commands, they are:

- [Effect Commands](https://github.com/Guitar-Sound-Processing/GSP/blob/main/gsp_daisy/Commands.md) (interpreted by Daisy Seed)
- Presets (interpreted by GSP Android)
- Chain Profiles (interpreted by by GSP Android)
- Songs (interpreted by by GSP Android)
- Playlists (interpreted by by GSP Android)

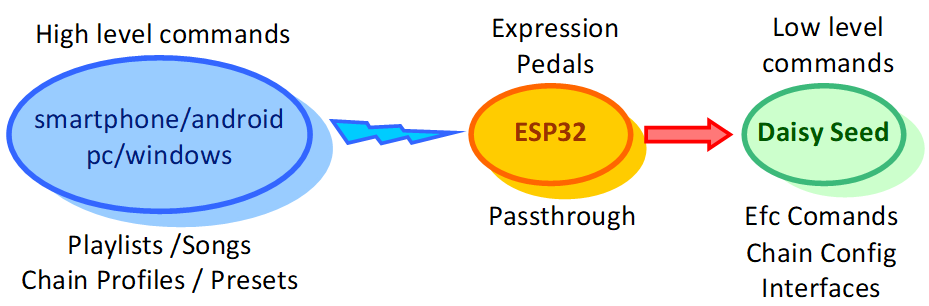
[picture p20: resources/hl_com.png]
High and Low Level commands


ESP32 was programmed using ESP32 board on Arduino IDE. The source code is available here for download.
