Guitar-Sound-Processing/GSP/ext_device/Presets.md

# Effect Presets

Some or all the effects can be associated to an effect preset previously stored in setup.txt file. This file shall contain the preset identification name following the [Effect Command](https://github.com/Guitar-Sound-Processing/GSP/blob/main/gsp_daisy/Effects.md) for that setup in each line:

```preset_id effect_command```

Here is some examples stored in setup.txt file:

```
overdrive1 ovd 1 1 0.2 
vibrat_1 vbt 1 10 1 5
myequalizer eql 1 0.5 .8 1
overdrive2 ovd 1 1 0.8 
```

Any effect preset can be selected with the ```set``` command:

```set mysetup```

where mysetup is one of the available presets stored in the setup.txt file. Some valid examples are:

```
set overdrive1
set myequalizer
```

The command ```set``` without preset_id causes a printout of the available preset ids on setup.txt file. For example:

```set```

>  ->overdrive1</br>
>  ->vibrat_1</br>
>  ->myequalizer</br>
>  ->overdrive2</br>

However, if the ```set``` (without ```setup_id```) command is inserted in any Chain Profile then DS answers with unknown command:

>  -> ?
