Guitar-Sound-Processing/GSP/gsp_daisy/Effects/Phaser/Phaser.pdf

## Phaser

VCarrara

### Definition

Phaser is the effect produced by combining a filtered and non-filtered signal. The filtered signal passes through a variable all-pass filter modulated by a Low Frequency Oscillator (LFO). Several stages of all-pass filter with variable phase shift each makes the mixed signal resonating like a jet motor. Phaser is closed related with Flanger and Chorus. The signal in Flanger is delayed by variable time modulated by a LFO and then combined with the source. On the other hand, in the Chorus effect the signal is combined with several delayed copies with slightly pitch and frequency variations driven by a LFO.

### Phaser

The Phaser is normally formed by several identical modules placed in series. One of them is shown in the Figure 1. Each two of these modules shifts the wave phase by 180º at the resonant frequency of the high-pass filter formed by the capacitor C and the resistor R, explained below. Some modules have only the resistor, while others have an LED-LDR (Light Dependent Resistor) set in parallel to the resistor. The LED-LDR set is driven by an LFO (Low Frequency Oscillator) which therefore varies the resonant frequency of each module. In Figure 1 the LED-LDR was replaced by an Rc potentiometer.

Rp

un+1

R1

C

un | +
- R1 … | …

## ux uy

Rc
i2

i1

Fig. 1 – A single stage of the Phaser resonant filter.

Phaser model

Considering un as the voltage input to the module n (n = 1, …, N) and un+1 its output, then the elementary equations in Z transform for this circuit are

1

1 2

(1 | )
2 (1 | ) n | x
T | z U | I U
C z

,

U | R I x | 2
,
U | R I U n | y | 1 1 | ,
U | R I U y | n | 1 1 | 1
,

1

( | ) U | K U U n | y | | ,

neglecting the currents on the operation amplifier inputs, and considering that R is the equivalent resistor from the high-pass filter, which depends of Rp and Rc. T is the audio sampling interval in seconds. The transfer function of this circuit can be obtained by solving this set of equations, resulting in

1

1 1

| (2 | ) | 2
( 2 | 4 | 2 ) | 2 | 4 | 2 n | n
K C R T z | K C R T U | U
K C R K T | C R | T z | K C R K T | C R | T

,

but given that the operational amplifier gain is such that K >> 1, the above equation results

1

1 1

(2 | ) | 2
(2 | ) | 2 n | n
C R T z | C R T U | U
C R T z | C R T

By expressing this relation in time domain, it comes to

1 | 1 ( ) | ( ) | ( | 1) | ( | 1) n | n | n | n u | k | bu k u k | bu | k | | | | ,

such that

2
2

C R T b
C R T

Now all modules can be joined in cascade, with audio input given by u0(k) = ue(k) and output uN(k):

1 | 0 | 1 | 0 u k | b u k u k | u k ( ) | [ ( ) | ( | 1)] | ( | 1) | | | ,
2 | 1 | 2 | 1 u k | b u k u k | u k ( ) | [ ( ) | ( | 1)] | ( | 1) | | | ,
1 | 1 ( ) | [ | ( ) | ( | 1)] | ( | 1) N | N | N | N u k | b u | k u k | u | k | | | |
,

Finally, the output from the Phaser can be equally mixed with the audio input, giving

( ) | [ ( ) | ( )] s | N | e u k g u k u k |

where g is the output gain (0 < g 1). Based on the Phaser 100 pedal, it was chosen 10 cascade levels for this model (N = 10).

Phaser controls

The resistor Rp and capacitor C in the Phaser 100 effect pedal are 20 k and 10 nF, respectively. The LED-LDR driven by a LFO changes the equivalent resistance R from a very low value (few hundreds of Ohms) up to something around 20 k. Since the LED-LDR is driven by an oscillator, R changes in a sinusoidal wave. Moreover, since b depends only on the product C R, just one parameter needs to be adjusted in the phaser model. However, and considering that the proposed Phaser model is rather simple, some tests were performed to check the resulting audio, and a reasonable result for R was obtained with two resistors in series, as shown in Figure 2. In other words, R can be modeled by

( ) R R f t | R | c | lfo | p

where flfo(t) is the Low Frequency Oscillator function, such that 0 flfo(t) 1.

Rp
Rc LFO

Fig. 2 – The equivalent circuit of the LED-LDR resistor.

These two resistors have similar yet different behavior. Rc can be associated with the oscillator amplitude, or effect level, while Rp increases or decreases the effect depth. By trial and error, the maximum values obtained for Rc and Rp were 100 k and 500 k, respectively. Rp action is reciprocal, which means that the effect depth is more noticeable when its value is close to zero. Moreover, its effect is nonlinear, so Rp shall be computed empirically by

10
6
10
1 e 0.5 1 | 10

### 1 e

d
Rp

where d is the Phaser depth (0 d 1). In similar way Rc can be expressed by

5 10 R a c

in which a is the amplitude level (0 a 1).
