Guitar-Sound-Processing/GSP/gsp_daisy/Effects/Wah_Wah/Wah_Wah.pdf

## Wah-wah

VCarrara

### Definition

The Wah-wah effect changes the tone of the input signal in response to a rocking potentiometer. The circuit is based on a second order resonant filter (RCL – Resistor, Capacitor, Inductor), in low-pass filter configuration. A variable capacitor should adjust the resonant and cutoff frequency, but it is expensive and also large. To overcome this problem, normally the variable capacitor is replaced by a Miller effect capacitor circuit, which feeds the signal back through the capacitor by means of two transistors. Increasing the current in the capacitor has the same effect as an increase in its capacitance. The current is modulated by an action potentiometer (pedal), and therefore changes the resonant frequency. Although the Wah-wah circuit is rather complex, to simulate it a simple RCL resonant circuit is necessary, with a variable capacitor, as can be seem in Figure 1.

C R

us

iC

iR

ue L

Fig. 1 – RCL resonant circuit of a wah-wah pedal.

The elementary equations in the Z transform domain are:

U | R I s | R | ,

1

1

1
2 1 s | C
T | z U | I
C z

,

1

1

1
( | )
2 1 C | R | e | s
T | z I | I | U U
L z

,

for the resistor, capacitor and inductor, respectively. This set of 3 equations can be solved for the input and output signals, resulting in

2 1
2 | 1 | 0
| 2 1
2 | 1 | 0
s | e
B z | B z | B U | U
A z | A z | A

in which

2

2 A RT | LT | C L R | | 2 | 4

2

1 A | R T | C L R | 2 | 8

2

0 A R T | LT | C L R | | 2 | 4
2 B | RT 2

2

1 B | RT 2
2 B | RT 0

where T is the sampling rate period (T = 1/fs). In time domain the transfer function becomes

0 | 1 | 2 | 2 | 1 ( ) | ( ) | ( | 1) | ( | 2) | ( | 2) | ( | 1) s | e | e | e | s | s u k | b u k | b u k | b u k | a u k | a u k | | | | | .

where the coefficients are obtained by

2
2
2 2
0

2 4
2 4
A | R T | LT | C L R
a
A | RT | LT | C L R
| | 2
1
1 2
0

2 8
| | 2 4
A | RT | C L R
a
A | R T | LT | C L R

2
2
2 2
0 | 2 | 4

B RT b
A | RT | LT | C L R

2
1
1 2
0

2
2 4

B R T b
A | R T | LT | C L R

2
0
0 2
0 | 2 | 4

B R T b
A | RT | LT | C L R

The capacitance can be linearly adjusted in software by means of

0 | 1 | ( ) C C C f t | | lfo

where C0 and C1 are constants and flfo (0 flfo 1) can be obtained by a low frequency oscillator (LFO), by reading a potentiometer attached on the pedal, or by a function generator. Simulations performed on Circuit Simulator from Falstad¹
had shown that the
bias current in the capacitor changes its capacitance from 15 nF minimum, up to something close to 110 nF, therefore resulting in C0 = 15 nF, and C1 = 95 nF, approximately. The RCL circuit of the Wah-wah Vox pedal uses a 33 kOhms resistor, a 10 nF capacitor, and a 600 mH inductor. The Bode diagram of the response shows a peak at the circuit's resonant frequency, which changes with the action of the potentiometer attached to the Miller circuit. A higher capacitor causes a reduction in the resonant frequencies. According to Electrosmash's Vox page²
, the resonant frequencies of the Vox V847 wah-wah range from 450 to 1.6 kHz, as seen in the Bode diagram of Figure 2.

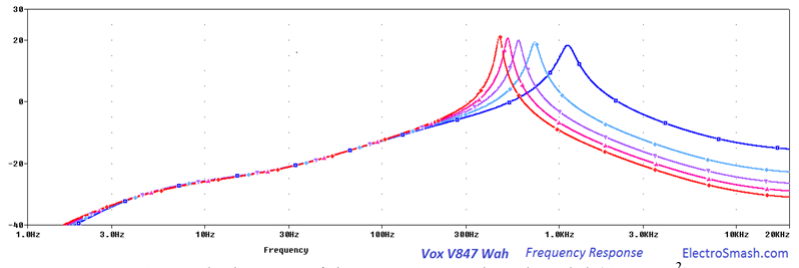
[picture p21: figure]

Fig. 2 – Bode diagram of the Vox V847 Wah-wah pedal (Source: ² )

However, the resonant peaks in the bode diagram of the RCL transfer function show a different interval, ranging from 3.8 kHz up to 10 kHz. The resonant frequencies can be adjusted by changing the RCL values, but the best values based on the output audio are the original ones from the Vox pedal with doubled inductor (L = 1.2 H), whose Bode diagram is presented in Figure 3, for flfo ranging from 0 (red) to 1 (blue), with 0.25 increments. Magnitude ⁽dB⁾

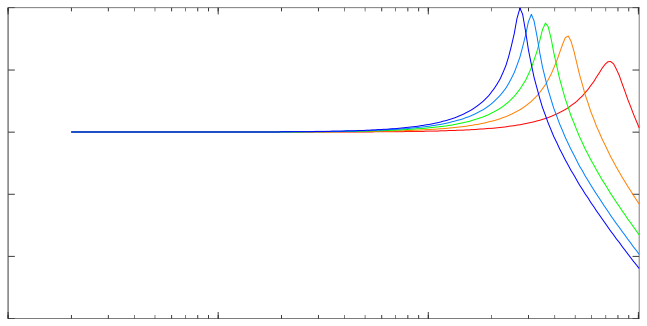
[picture p22: figure]

Fig. 3 – Bode diagram of Wah-wah simulator.

Higher values of the capacitor reduce the resonant frequencies and increase the height of peaks. On the other hand, by raising the inductor the frequencies also decrease, together with the peaks. In other words, an increasing of both the inductor and capacitor can lower the resonant frequencies while keeping the resonant peaks almost unchanged. As consequence, wah-wah tone becomes lower. The resistor R affects the peak height, by increasing the peaks for higher values of the resistance, still leaving the resonant frequency constant. This makes the wah-wah output louder, with larger frequency range. Based on these results, a new approach to compute the coefficients of the transfer function is proposed:

C | f C 1 CL | v ,
L f L CL | v ,
R f R R | v ,

where fCL and fR are gains to increase or decrease the wah-wah tone and effect depth, respectively. Low values of fCL increase high frequencies on output, and high values of fR increase the depth. It was noted that changing C0 produces only small variations on the wah-wah output, so it can remain static. With the before mentioned values of the resistor, capacitor and inductor, fCL can be adjusted between 0 (no effect) up to 4. On the other hand fR shall be kept in the range between 0.2 to 4, although high values tend to promote distortion due to saturation on audio signal.

### References

1
Falstad. Circuit Simulator. Available at: <https://www.falstad.com/circuit/>, 2023.

2
Electrosmach. Vox V847 Wah-Wah Analysis. Available at: <https://www.electrosmash.com/vox-v847-analysis>, 2023.
