Guitar-Sound-Processing/GSP/gsp_daisy/Effects/Overdrive/Overdrive.pdf

## Overdrive (Distortion)

VCarrara

### Definition

Distortion, sometimes also called Overdrive or Fuzz, can produce distorted sounds with increasing loudness. Basically a distortion effect amplifies the input audio, following by clipping the signal up to a preselected level.

The clipping process in digital sound processing is usually made with hard clipping, i.e., just saturating the absolute input to a given maximum value. However, this easy procedure produces high and undesirable 3rd order harmonics on the original sound. Other clipping functions, like logarithm and arc tangent are largely employed but they also have some drawbacks similar to the hard clipping. These problems drove the solution to choose a distortion algorithm that mimics some existing analog distortion. It was choose the Big Muff (BM) which gives smooth transition between soft and hard distortion.

### Big Muff Distortion

The Big Muff has three stages: a driver or pre-amplifier, 2 steps of distortion and a filter (tone) section. This pedal has also three control buttons: Sustain, Volume and Tone. All these controls were also included in the model.

Clipping Stages

Figure 1 shows the first two stages of Big Muff: the driver in red and the first step of distortion in green. The Sustain potentiometer can be seen at driver’s output. The distortion stage presents two anti parallel diodes for audio clipping. A simulation of this circuit has shown that the 470 uF capacitor can be removed from the circuit without loss. However even considering this simplification, the distortion stage is still too complex to be simulated in real time in a microcontroller.

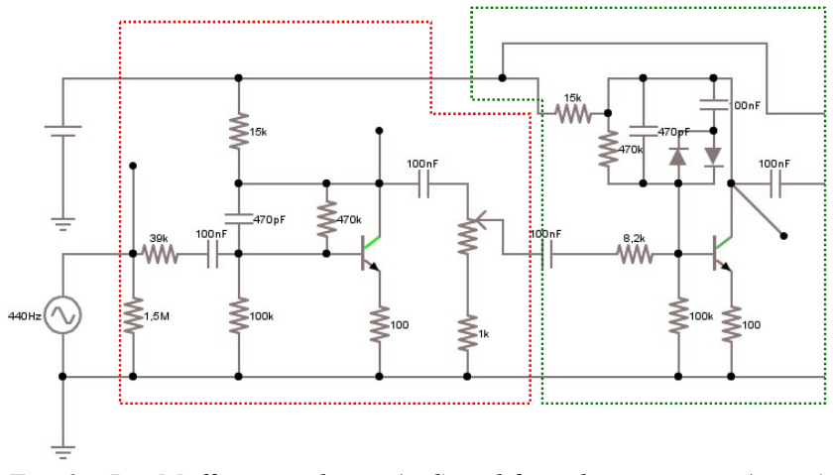
[picture p23: figure]

Fig. 1 – Big Muff’s input driver (red) and first clipping stage (green)

The simplest circuit that can be built with a pair of clipping diodes is the one shown in Figure 2, based on the Big Muff pedal. The diodes are placed in series with a resistor and capacitor, which act as a low-pass filter. It is evident that the diodes cannot be modeled as being ideal, because ideal diodes act like hard limiter, so having the same problems of hard clipping, and, therefore, loses important characteristics of dynamics. The main effect that is desired is the non-linear characteristic presented by the diodes.

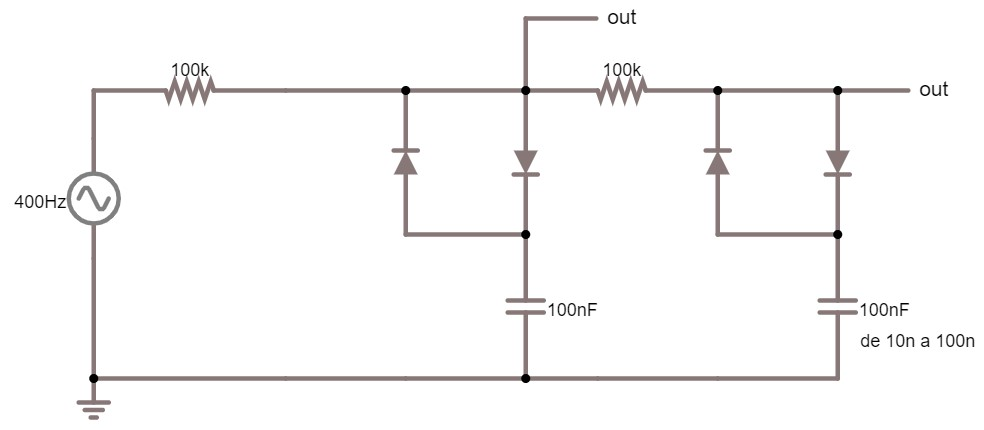
[picture p24: figure]

Fig. 2 – A simple circuit of two-stage diode clipping.

BM uses 1N914 diode, which can be modeled using the I x V curve from the datasheet, giving

(10 9) 10 dv
d

i

- | ,

where vd is the voltage (V) applied on the diode and id is the current in Amperes. It is assumed that the reverse current is negligible. From this model it can be easily seem that a non-zero current flows through the diode even when the applied voltage is null. To correct this anomaly, this model is slightly changed to

(10 | 9) | 9 10 | 10 d v
d

i

which makes id = 0 when vd = 0. Since both distortion steps are identical, only one will be modeled. The clipping circuit is shown in Figure 3, comprising the diodes in series with a resistor and a capacitor. The elementary Z-transform for the resistor and capacitor are:

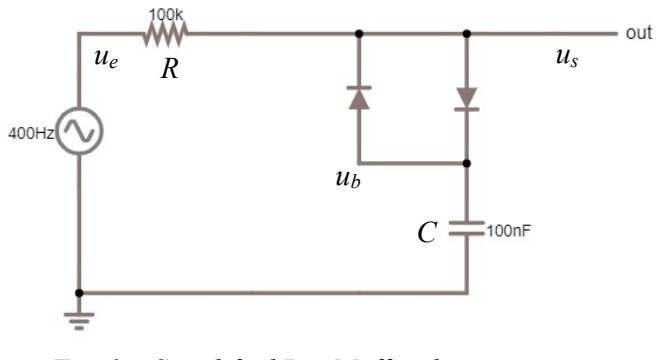
[picture p25: figure]

Fig. 3 – Simplified Big Muff’s clipping circuit.

U | R I U e | s |

1

1

1
2 1 b
T | z U | I
C z

where T is the period of the sampling rate. The non linear diode function can only be derived in the inverse Z-transform as function of the applied voltage vd, which takes to

U V U s | d | b

The above equations can now be solved for the output voltage Us as function of the input voltage Ue and the diode voltage Vd, resulting in

1 1

1 1

1 | 2 | ( | 1)
( | 2 | ) | 2 | ( | 2 | ) | 2 s | e | d
z | CR z U | T | U | V
T | CR z | CR T | T | CR z | CR T

,

and since the diode voltage needs to be computed, the solution for Ub needs also be obtained which results

1 1

1 1

1 | ( | 1)
( | 2 | ) | 2 | ( | 2 | ) | 2 b | e | d
z | T z U | T | U | V
T | CR z | CR T | T | CR z | CR T

In time domain, these expressions can be formulated by

1 | 1 | 0 | 1 | 0 ( ) | ( 1) | ( 1) | ( ) | ( 1) | ( ) s | s s | s e | s e | s d | s d u k | a u k | b u k | b u k c v k | c v k | | | | | ,

in which the coefficients are

1

2
2

s

C R T
a
C R T

,

1
2

s

T
b
C R T

,

0
2

s

T
b
C R T

,

1

2
2

s

C R
c
C R T

,

0

2
2

s

C R
c
C R T

,

and

1 | 1 | 0 | 1 | 0 ( ) | ( | 1) | ( | 1) | ( ) | ( | 1) | ( ) b | b b | b e | b e | b d | b d u k | a u k | b u k | b u k c v k | c v k | | | | | ,

where

1

2
2

b

C R T
a
C R T

,

1 | 0 | 2
b | b

T
b b
C R T

,

1 | 0 | 2
b | b

T
c c
C R T

,

and such that R = 100 k, C = 100 109
F, and the sampling period T is 1/44100 sec. In order to include the diode model, from Kirchoff law in time domain the resistor current can be expressed by
e | d | b
r

u v u i
R
- ,

but this current is also equal to the diode current (ir = id), which leads to the transcendental equation

(10 | 9) | 9
[10 | 10 ] dv
e | d | b u | v u | R | | | .

which is valid only if ue > ub (for vd positive). An example of curves of ir (blue) and id (red) can be seen in Figure 4. By substituting the expression of ub in the above equation, it yields

(10 | 9) | 9
0 0
1 | 1 | 1
(1 | ) ( ) (1 | ) ( ) [10 | 10 ]
( | 1) | ( | 1) | ( | 1)

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

,

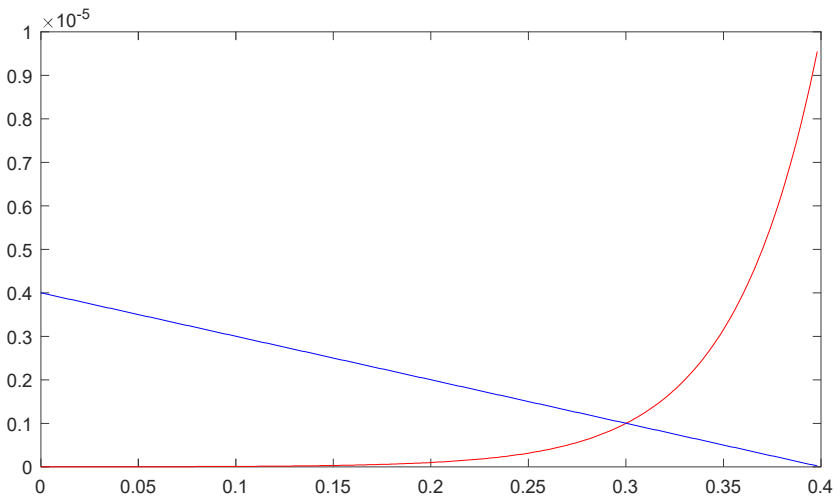
[picture p26: figure]

Fig. 4 – Current through resistor (blue) and diode (red).

This expression can be rearranged as function of vd, resulting

[10 ( ) 9] | 9
0 | 0 ( ) (1 | ) ( ) [10 | 10 ] | ( ) (1 | ) ( ) 0 dv k
d | b | d | b | e f v | c v k | R q k | b u k | | | | | | ,

where

1 | 1 | 1 ( ) | ( 1) | ( 1) | ( 1) b b | b e | b d q k | a u k | b u k | c v k | | | ,

that can only be solved numerically. By applying a Newton-Raphson method to f(vd) an iterative solution is obtained:

[10 ( ) 9]

0 1 | 10 10 | ln(10) dv k
b
d
df | c | R
dv

1

1

1 | 9 [10 | ( ) 9]
1 | 0 | 0
[10 | ( ) 9]
0
(1 | ) | ( ) [10 | 10 ] | ( ) (1 | ) ( ) ( ) | ( )
1 | 10 10 | ln(10)

j
d

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

where superscript j indicates the number of iterations (j = 0, 1, 2, …). With only three iterations a good approximation of the true value is achieved. However, a single iteration was adopted, to increase algorithm speed. This does not jeopardize the solution, because from an input ue at time k to the next input at k+1 only small differences occurs in the audio signal, which means that the true value is reached after few audio samples. By
adopting 0 | 1 ( ) | ( 1) d | d v k | v k | the iteration converges quickly, providing changes in signal
level remain bounded. The exponential term in the above equation can be provided by a suitable lookup table.

Each clipping stage results in three equations for us(ue, vd), vd(ue, ub) and ub(ue, vd). However, both us and ub depend on vd, and vd is also function of ub, because ub is required to know whether vd is positive or negative. The exact solution for this system is to iterate ub and vd, and then using vd to obtain us. In other words, the sequence of computation is to assume some previous value to ub and vd (null value, for instance), and then to compute iteratively 0

( ) d v k 0

( ) b u k 1

( ) d v k 1

( ) b u k till the solution reaches a required error. The proposed solution consists of considering ub(k) ub(k 1) to define the sign of vd (positive or negative), and then computing vd in a single iteration. The following algorithm is then proposed:

### 1. Initialize variables with

(0) | (0) | (0) 0 s | b | d u | u | v | | .

### 2. Starting with k = 1, compute

If ue(k) > ub(k1), make 0

( ) | ( 1) d | d v k | v k | | , and compute
1 | 1 | 1 ( ) | ( 1) | ( 1) | ( 1) b b | b e | b d q k | a u k | b u k | c v k | | | ,

0

0

0 9 [10 ( ) 9]
1 | 0 | 0 | 0
[10 ( ) 9]
0
(1 | ) ( ) [10 | 10 ] | ( ) (1 | ) ( ) ( ) | ( )
| 1 | 10 10 | ln(10)

d

| | d

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

,

and

1

( ) | ( ) d | d v k | v k | .

Otherwise, if ue(k) < ub(k1), then make 0

( ) | ( 1) d | d v k | v k | | , and
1 | 1 | 1 ( ) | ( 1) | ( 1) | ( 1) b b | b e | b d q k | a u k | b u k | c v k | | | ,

0

0

0 9 [10 ( ) 9]
1 | 0 | 0 | 0
[10 ( ) 9]
0
(1 | ) ( ) [10 | 10 ] | ( ) (1 | ) ( ) ( ) | ( )
| 1 | 10 10 | ln(10)

d

| | d

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

,

and

1

( ) | ( ) d | d v k | v k | .

Otherwise, if ue(k) = ub(k1), then ( ) 0 d v k

### 3. Now compute the output us and update ub:

1 1

1 | 1 | 0 | 1 | 0 ( ) | ( 1) | ( 1) | ( ) | ( 1) | ( ) s | s s | s e | s e | s d | ub | s d u k | a u k | b u k | b u k c v k | s c v k | | | | | ,
1 | 1 | 0 | 1 | 0 ( ) | ( 1) | ( 1) | ( ) | ( 1) | ( ) b | b b | b e | b e | b d | b d u k | a u k | b u k | b u k c v k | c v k | | | |

### 4. For the second clipping stage the variables are initialized with

(0) | (0) | (0) 0 s | b | d u | u | v | | , and | ( ) | ( ) e | s u k | u k | . The above algorithm can be
repeated, except that new variables have to be created for us, ub and vd.
5. Increment k and repeat steps 2, 3 and 4.

This algorithm has been tested and it worked correctly. A comparison with the exact solution (several iterations) showed that the single iteration differs from the exact solution by only 2% of the peak value. This error is most pronounced during changes in the vd sign. Figure 5 shows the output for a sinusoidal input signal with a frequency of 440 Hz and amplitude of 1 V, with only one stage of distortion. The same signal is presented in Figure 6, but with two identical stages. A gain of 2.5 was applied in the output of the first stage. It can be noted that the second stage makes the waveform even sharper, that is, the second stage increases the distortion level, yet keeping the desired smoothness to decrease the predominance of the odd harmonics.

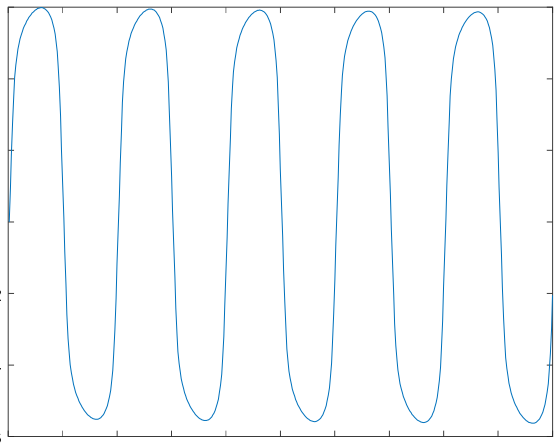
[picture p27: figure]

Fig. 5 – First stage clipping of a sinusoidal signal.

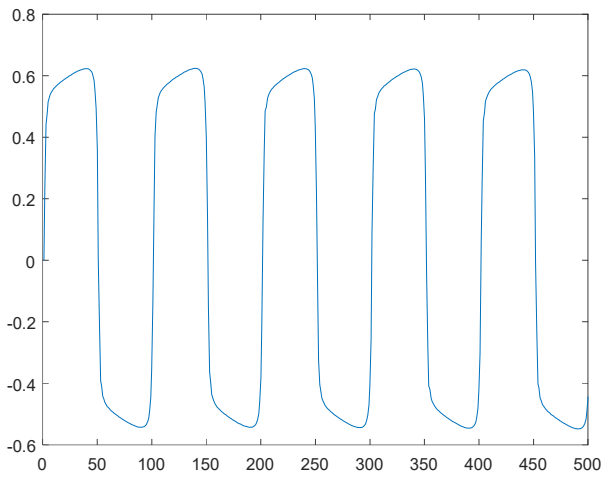
[picture p28: figure]

Fig. 6 – First and second clipping stages applied to a sinusoidal signal.

Sustain Level

Despite the promising results, it was later noted that a simple change in the input level by applying a selected gain does not mimic the effect of BM’s Sustain potentiometer. The best result was obtained with an input gain given by g1 = 3 (0.95 s + 0.05), a fixed gain of g2 = 2 after the first clipping stage, and a gain of g3 = 0.6 (4 – 2.5 s) after the second clipping stage (before the filter section), where s stands for the Sustain level (0 s 1). Some of these adjustments were made by comparing the wave shapes of a sine audio signal on the BM simulator and the real pedal wave on oscilloscope. Figure 7 indicates the gain level at each stage of the digital BM.

ue | us Clipping
3(0.95s+0.05) | 2 | 0.6(42.5s)
Clipping | Filter

Fig. 7 – Inter stage gains of the Big Muff model.

Filter Stage

The filter stage was based on the circuit of the Big Muff’s tone filter. This filter is composed of a low-pass filter (LPF) and a high-pass filter (HPF), whose outputs are combined by a potentiometer, as can be seen in the Figure 8. Each individual filter has one resistor and one capacitor. The input to the filter is the ue voltage, while the output is the us voltage.

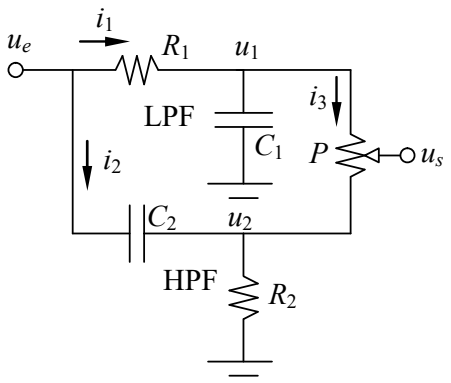
[picture p29: figure]
us LPF; HPF

Fig. 8 – Filter circuit of Big Muff.

By applying the Z transform to this circuit, the elementary equations are given by

1 1 1
1

2 2 1
2
1 | 2 | 3
2 | 2 | 2 | 3
| | | 1
1 | 1 | 3 1
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
U U | R I
T | z U U | I
C z
U U P I
U R I I
T | z U | I I
C z
U U P I

,

in which is the potentiometer gain (0 1), from LPF up to HPF. This set of equations can be solved for Us as function of Ue, resulting in

1 2
0 | 1 | 2 1 2
0 | 1 | 2
s | e
B | B z | B z U | U
A | A z | A z

where

2 | 2 | 1 | 2 | 2 | 1 | 2 | 1 | 2 B | P R | P R X R | P X X R R | | | | ( | ) | ( | 1)
1 | 2 | 1 | 2 | 1 | 2 B | P | R | P X X R R | | | 2 | 2 | 2 | ( | 1)
0 | 2 | 1 | 2 | 2 | 1 | 2 | 1 | 2 B | P R | P R X R | P X X R R | | | | ( | ) | ( | 1)
2 | 1 | 2 | 1 1 | 2 | 2 | 1 | 2 | 1 | 2 | 1 | 2 | 1 | 2 A | P R R | P X R X R | X X R R | P X X R R | | | | ( | ) ( | )
1 | 1 | 2 | 1 | 2 | 1 | 2 A | P | R | R | P X X R R | | | 2 | 2 | 2 | 2
0 | 1 | 2 | 1 1 | 2 | 2 | 1 | 2 | 1 | 2 | 1 | 2 | 1 | 2 A | P R R | P X R X R | X X R R | P X X R R | | | | | ( | ) ( | )

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
The inverse Z transform now can be performed and yields:

1 | 2 | 0 | 1 | 2 ( ) | ( | 1) | ( | 2) | ( ) | ( | 1) | ( | 2) s | s | s | e | e | e u k | a u k | a u k | b u k | b u k | b u k | | | | | ,

in which ai = Ai/A1, and bi = Bi/A1. The resistors and capacitors values adopted here differ a bit from the original BM pedal: C1 = 10 nF, C2 = 3.9 nF, R1 = 39 k, R2 = 100 k, P = 100 k, such that the coefficients result in

0 = 0.038252490268891
1 = 0.003071673766032
2 = 0.035180816502860

0 = 0.907850385995433
1 = 1.818772445756898
2 = 0.907850385995433

a1 = 1.813565958723474
a2 = 0.820907259024290

with bi = i + i.

BM Output

Figures 9 and 10 show the output from the BM model and from the analog pedal, respectively. The first graphic was obtained from computation on personal computer. The next figure was captured from an oscilloscope. The input signal was a sine wave for both, simulated and the real pedal. The Sustain control was adjusted to maximum.

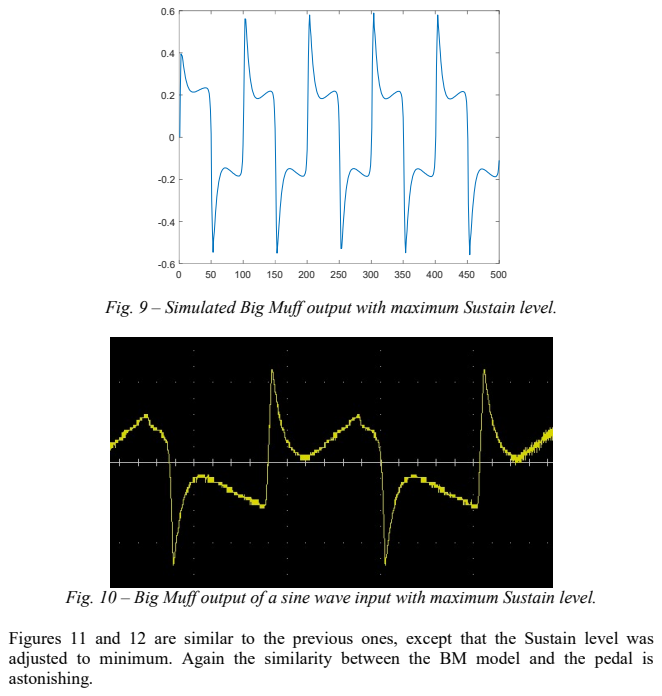
[picture p30: page 10]

Fig. 9 – Simulated Big Muff output with maximum Sustain level.

Fig. 10 – Big Muff output of a sine wave input with maximum Sustain level.

Figures 11 and 12 are similar to the previous ones, except that the Sustain level was
adjusted to minimum. Again the similarity between the BM model and the pedal is
astonishing.

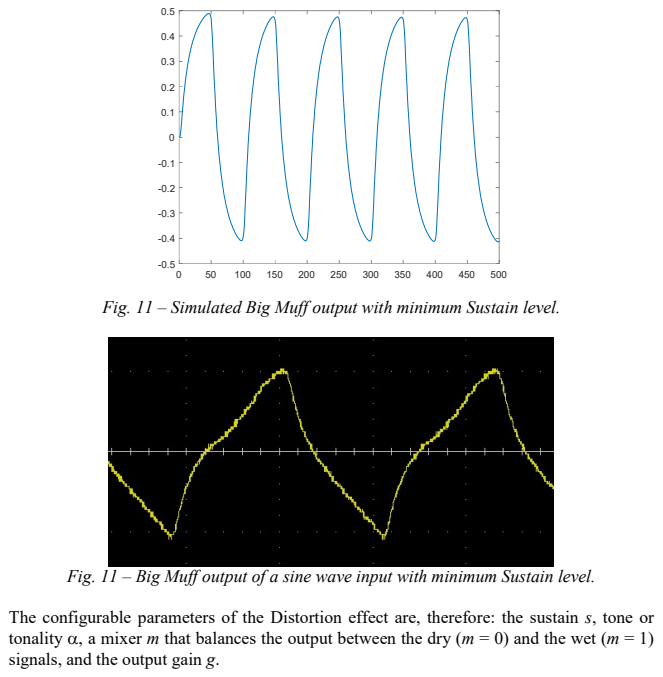
[picture p31: page 11]

Fig. 11 – Simulated Big Muff output with minimum Sustain level.

Fig. 11 – Big Muff output of a sine wave input with minimum Sustain level.

The configurable parameters of the Distortion effect are, therefore: the sustain s, tone or
tonality , a mixer m that balances the output between the dry (m = 0) and the wet (m = 1)
signals, and the output gain g.
