Guitar-Sound-Processing/GSP/gsp_daisy/Effects/Detune/Octave-Detune-Pitch_Shifter.pdf

## Octave, Detune and Pitch Shifter

VCarrara

### Definition

A Pitch Shifter changes the audio signal frequency without changing its time, by either increasing or decreasing the frequency. Although the algorithms presented here can be generalized to work in both directions, they will be separated into 3 similar algorithms: in the first one, the frequency shall be increased, which will be named as Pitch Shifter; in the second the frequency will be decreased, named Detune, while the third one will have the exclusive function of doubling the frequency, named Octave. This separation allows each algorithm to be customized for its functionality and, furthermore, the implementation of different algorithms allows two of them to be used simultaneously, such as, for example, the Pitch Shifter and the Octave.

The usual way to perform a frequency shift is to resample the input signal with the same sampling frequency, but by increasing or by reducing the time interval between samples. When the resample interval is increased in relation to the input signal, there will be an increase (Pitch Shifter) of the output frequency, or a frequency reduction (Detune) when the interval is compressed. To maintain the time duration of the original signal, several windows, or intervals, of the input signal samples are superimposed to compose the tone-altered signal. The algorithms of the three types of effects will be presented below.

### Pitch Shifter

For the Pitch Shifter a tonal transformation is adopted, such that a continuously variation parameter s indicates the number of semitones to be increased in the input signal (0 s 12), so the frequency ratio between the input and output signal, p = fs/fe, can be computed by

/12 2

s p .

From the above equation is easy to see that when p is unity (s = 0) the output frequency equals to the input, and when p equals 2 (s = 12) the frequency is doubled. Figure 1 shows the input signal at the top, and the output signal at the bottom, which is composed of a combination of two distinct intervals of the input signal, modulated by two sine envelopes out phased by 90 degrees. Thus, while one of the input interval increases in amplitude, the other decreases. On the next interval the increasing signal will then decrease, and a new increasing interval will be added to the output signal. The sine envelopes are shown in the figure, with its increasing part at top and decreasing at bottom. Colors identify the input intervals. In the Pitch Shifter each input window is larger than the re-sampled output signal. Since the increasing and decreasing intervals are symmetric, only one window needs to be formulated. At the end of the decreasing interval the pointer of the input audio buffer is stored in an integer variable ji. At this time the input and output signal are synchronized with no delay. The length of each window is given by me, which corresponds to an output window with half size, ms, computed by:

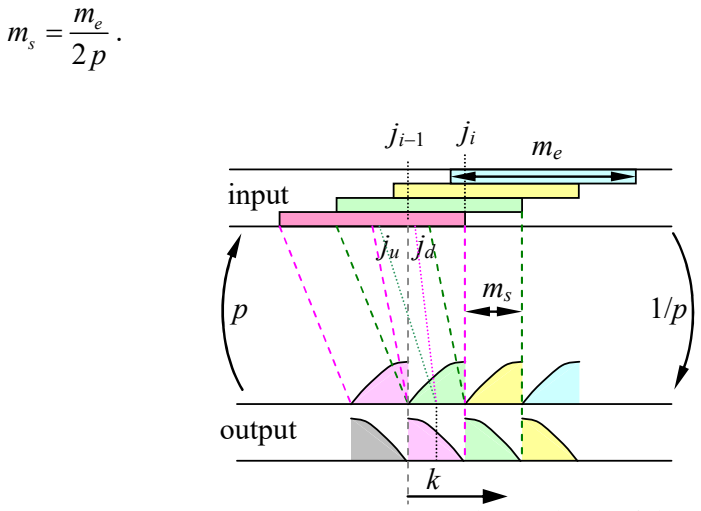
[picture p32: figure]
input; output

Fig 1 – Time intervals and sample windows of the Pitch Shifter.

In Figure 1 the variable k is a pointer to the output buffer, related to the addresses in both input windows to compute the output signal at this time. k varies between 0 and ms, with unit increment, at the same sampling frequency of the input signal. When k reaches the half-size window ms, pointer ji is incremented by ms, and k starts the next interval (k = 0). Despite the input window size being me, ji is incremented with ms, which makes the increasing and decreasing windows to overlap, as shown in Figure 1. They overlap each other by ¾ when s = 12 and by half size when s = 0.

Window lengths in the input signal are converted to window lengths in the output signal by multiplying the length by 1/p. As p is always equal to or greater than 1, then the time in the output signal is shortened, and the audio frequency is increased. Similarly, an interval length in the output signal corresponds to a length increased by a factor p in the input audio. The dashed lines in the figure indicate this linear transformation, which allows the input audio to be re-sampled as function of k, resulting in pointers ju and jd in the input buffer for increasing and decreasing interval, respectively. In fact, from Figure 1 it can be seen that:

(2 | ) i | s | u | s j m j | p m k |
( | ) i | d | s j j | p m k |

which can be rewritten in the form

(1 2 ) u | i | s j | j m | p | p k | |
d | i | s j | j p m p k |

Note that the pointers ju and jd to the input buffer are always smaller than the output pointer at instant k, given by ji + k. Both ju and jd may be or may be not integers. For high sampling frequencies, above 20 kHz, no interpolation in the input buffer shall be required. The maximum delay between input and output signals occurs when the sine amplitudes are at maximum value, which happens at k = 0 or k = ms. and is given by

( 1) s

s

m
t p
f

where fs is the input sampling rate (normally 44.1 kHz). So the maximum delay depends on the selected tone increment s, and can vary from no delay up to ms/fs. Defining now the angle (k) by

( ) | 2 s

k
k
m
- ,

the output signal can be computed with

sin( ( )) ( ) sin( ( ) | / 2) ( ) s | e | u | e | d u | k u j | k | u j | | |

in which ue and us are the input and output audio buffers, respectively. Very high window lengths, with me above 8000, for a sampling frequency of 44.1 kHz, tend to improve the quality of the output signal, reducing vibrato introduced by the sine envelope. On the other hand, long lengths compromise the synchronicity between input and output, making the delay clearly audible. Short lengths for me (less than 4000) tend to introduce undesirable harmonics in the output signal, making it “metallic”, but it improves the synchronism. A good compromise between both characteristics can be found with me in the range between 5000 and 6000.

### Octave

The Octave has the same formulation as the Pitch Shifter, but in Octave the parameter p is constant and equals to 2. The equations of this model are:

4

e
s

m
m .

and the input buffer pointers will be obtained by

3 | 2 u | i | s j | j | m | k | | ,
2 | 2 d | i | s j | j | m | k | | .

When k = 0, ju is 3ms samples out of phase with the input signal, while jd is 2ms samples out of phase. When k is equal to ms, ju results ms samples off phase while jd is in sync with the input (jd = 0). The sine angle and the composition of the output signal us are calculated identically to the Pitch Shifter. A good compromise between time delay and audible artifacts on the Octave output was achieved with 3000 samples for me, at 44.1 kHz sampling frequency, which corresponds to a time window of 68 milliseconds, or a time delay of 17 milliseconds.

### Detune

The algorithm for Detune effect is similar to the Pitch Shifter, except for the frequency ratio, p, which now is the reciprocal of the Pitch Shifter. Figure 2 shows the input signal at top and the output at bottom. The output signal will again be composed of two intervals, modulated by sine profiles with 90 degrees out of phase. In this algorithm both the increasing input and output window are synchronized at beginning of a new cycle, when ji is incremented with ms and k is set to zero. The sampling interval in the input signal has length given by me, which corresponds to

2

e
s

m
m | p | ,

samples in the output signal. The variable k will again vary between 0 and ms, with unit increment, at the same sampling frequency of the input signal. When k reaches the half-sine interval ms, the ji pointer is incremented by ms, and k is reinitialized. Note that, despite the interval in the input signal being me, ji is incremented by ms, which causes the increasing and decreasing intervals in the input signal to partially overlap, as shown in Figure 2. They overlap by me/2 samples when p = 1 and zero samples when p is 2.

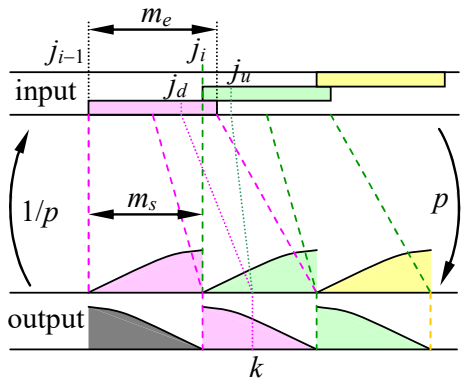
[picture p33: figure]
input; output

Fig 2 – Time intervals and sample windows of the Detune.

Time intervals in the input signal are converted to time intervals in the output signal by multiplying the interval by p. As p is always equal to or greater than 1, then the time interval in the output is expanded, and the frequency of the input audio is reduced. Analogously, a time interval in the output signal corresponds to a fraction 1/p in the input interval. The dashed lines in the figure indicate this linear transformation, which allows obtaining the input samples at position ju and jd in the increasing and decreasing intervals, respectively, as a function of the output time k. In fact, from the figure it can be seen that:

u i

k
j j
p

1

s
d | i
m k j | j
p

which can be rewritten in the form

u i

k
j j
p

1

d | i | s
p | k j | j m
p | p

It can be noted that the pointer to the output buffer is given by ji + k, which will always be greater than or equal to both ju and jd. When k is zero, ju equals to ji (in sync), while jd is delayed by ms ms/p samples. When k equals ms, ju and jd are delayed by ms/p and ms samples, respectively. The maximum latency can be computed by

### 1 s

s

m p
t
f p

The output signal us is computed by the same expression presented in the Pitch Shifter formulation. Best audio quality is achieved with high values of me, around 8000 samples. However, latency is noticeable on high tone changing, close to 12, but still acceptable. In this case the time delay (latency) is 91 milliseconds for 44.1 kHz sampling rate.
