Guitar-Sound-Processing/GSP/gsp_daisy/Effects/Equalizer/Equalizer.pdf

## Equalizer

VCarrara

### Definition

An equalizer adjusts the response frequency using audio filters to change the spectral characteristics of the audio input. Frequency ranges can be emphasized or attenuated using low-pass, high-pass, band-pass or band-stop (notch) filters¹
. Equalization is mostly used to improve the tonal quality of a recording or instrument, although filtering some undesirable frequencies is also highly employed on stage and recording sessions.

### Three-band equalizer

The model presented here is a parametric three-band equalizer, based on first-order filters, with a low-pass, followed by a band-pass and high-pass passive filters. Equalizers with four or more bands are possible by adding band-pass filters in between, as well as other types of filters, like Butterworth, second-order, active, etc. The three-band equalizer can be mathematically modeled with resistors and capacitors, with all filters in parallel. The equalizer can also have all filters in series, with different formulation. The band-pass filter is easily constructed joining a low-pass filter and a high-pass filter in series, which results in a second-order filter. Therefore, there are 4 filters in the three-band equalizer: two low-pass and two high-pass filters. Figure 1 shows the electric circuits of a low-pass (Cl, Rl) and high-pass (Ch, Rh) filters.

Rl

Cl

ue | Rh
ul | ue | Ch | uh
LPF | HPF

Fig. 1 – Low-pass filter (LPF) and high-pass filter (HPF) circuits.

The Z transform of a resistor R and capacitor C are, respectively

U z | R I z ( ) | ( )

1

1

1
( ) | ( )
2 1
T | z U z | I z
C z

,

where T is the audio sampling period, and u and i are the voltage and current on the resistor or capacitor, respectively.

Low-pass filter

The equations for the low-pass filter (LPF) is expressed using the Z transform formulas for the resistor and capacitor, resulting in:

1

1

1
2 1 l
l
T | z U | I
C z

,

U U R I e | l | l | .

The transfer function for the low-pass filter can now be obtained, resulting in

1

1

( | 2 | ) | 2 l | e
l | l | l | l
T z | T U | U
T | R C z | T | R C

,

or, when presented in time domain:

0 | 1 | 1 ( ) | ( ) | ( | 1) | ( | 1) l | l | e | l | e | l | l u k | b u k b u k | a u k | | | ,

and whose diagram is presented in Figure 2, in which

0 | 2 l | l | l a | T | R C

1
0

### 2 l l

l
l

T R C
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
- | ue | ul

bl0

z1

bl1

z1 al1

Fig. 2 – Z transform block diagram of a low-pass filter.

High-pass filter

The elementary equations in Z transform of the high-pass filter (HPF) are:

1

1

(1 | )
2 (1 | ) e | h
h
T | z U U | I
C z

,

U | R I h | h | ,

which results in the following transfer function

1

1

2 2
(2 | ) | 2
h | h | h | h
h | e
h | h | h | h
R C z | R C U | U
R C T z | | R C T

,

that can be transformed in time domain resulting in

0 | 1 | 1 ( ) | ( ) | ( | 1) | ( | 1) h | h | e | h | e | h | h u k | b u k b u k | a u k | | |

where the coefficients are given by

0 | 2 h | h | h a | T | R C | ,

1
0

### 2 h h

h
h

T R C
a
a
- ,

0
0

### 2 h h

h
h

R C b
a
- ,

1
0

### 2 h h

h
h

R C b
a

The block diagram of the transfer function of the high-pass filter can be seen in Figure 3.

ue | uh bh0

z1

bh1

z1 ah1

Fig. 3 – Block diagram in Z transform of a high-pass filter.

Band-pass filter

The band-pass filter (BPF) is composed by high-pass and low-pass circuits in series as shown in Figure 4. Although both circuits are connected by ui, it is assumed that the current flowing through this interface can be neglected, which significantly simplifies the equations without compromising the filter effectiveness.

Rbl

Cbl

ub

Rbh

u | Cbh e | ui | ui

Fig. 4 – Band-pass filter circuit.

As usual, the elementary equations for this filter in Z transform are:

1

1

(1 | )
2 | (1 | ) e | h | i
bh
T | z U | I U
C z

,

U R I i | bh h | ,
U R I U i | bl l | b | ,

1

1

(1 | )
2 | (1 | ) b | l
bl
T | z U | I
C z

,

which were solved by eliminating both currents and the voltage Ui, resulting in the second order transfer function:

2
2 0
2 1
2 | 1 | 0
b | b
b | e
b | b | b
B z | B U | U
A z | A z | A

,

where the coefficients are given by

2

0 | 2 | 2 | 4 A | T R C | T R C | T | R C R C b | bl | bl | bh | bh | bl | bl | bh | bh | | | ,

2

1 | 8 | 2 A | R C R C | T b | bl | bl | bh | bh | | ,

2

2 | 2 | 2 | 4 A | T R C | T R C | T | R C R C b | bl | bl | bh | bh | bl | bl | bh | bh | | | ,
2 | 2 B | T R C b | bh | bh | ,
1 0 Bb ,
0 | 2 B | T R C b | bh | bh | .

The transfer function can now be expressed in time domain, resulting

0 | 1 | 2 | 1 | 2 ( ) | ( ) | ( | 1) | ( | 2) | ( | 1) | ( | 2) b | b | e | b | e | b | e | b | b | b | b u k | b u k b u k | b u k | a u k | a u k | | | | | ,

and such that

b | b 0 | 0 a | A | ,
1 | 1 | 0 / b | b | b a | A A | ,
2 | 2 | 0 / b | b | b a | A | A | ,
0 | 0 | 0 / b | b | b b | B | A | ,
1 | 1 | 0 / b | b | b b | B A | ,
2 | 2 | 0 / b | b | b b | B | A | .

The block diagram of the transfer function can be seen in Figure 5.

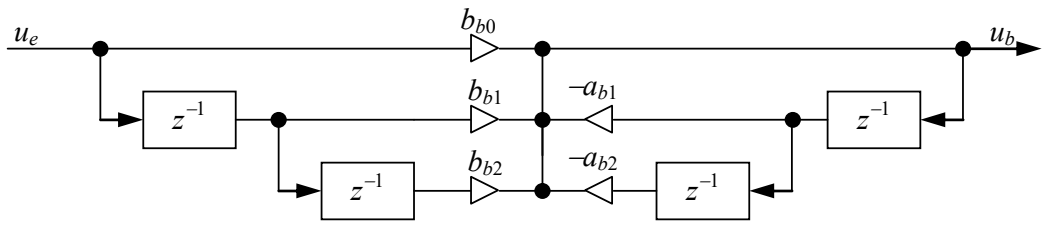
[picture p34: figure]

Fig. 5 – Block diagram of the band-pass filter.

Parametric Equalizer

In the three-band equalizer it is assumed that the output response is given by a linear combination from each filter such that

s | l | l | b | b | h | h u | u | u | u | | | ,

where each i (i = l, b or h) can be understood as a filter regulator (0 i 1), similar to a volume potentiometer. The block diagram of the Equalizer is shown in the Figure 6.

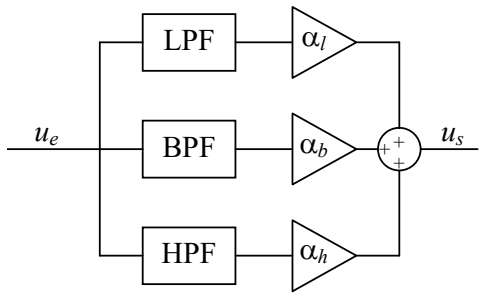
[picture p35: figure]
us LPF; BPF; HPF

Fig. 6 – Block diagram of the three-band equalizer.

The cutoff frequency of a filter is given by:

1
2

c

f
RC

,

which can be solved to express the RC product as a function of the cutoff frequency. So, instead specifying each resistor or capacitor, it is preferable to choose the cutoff frequency for each filter. Moreover, the cutoff frequency of the LPF shall be equal to the cutoff frequency of the high-pass circuit of the BPF. In other words, Rl Cl = Rbh Cbh. Similarly, the cutoff frequency of the HPF shall be identical to the cutoff frequency of the low-pass circuit of the BPF (Rh Ch = Rbl Cbl). If fl and fh are the cutoff frequencies for the LPF and HPF of the 3-band Equalizer, respectively, then

1
2
l | l | bh | bh
l

R C R C
f
1
2
h | h | bl | bl
h

R C R C
f

The Bode diagram of the transfer function can be seen in the Figure 7, for cutoff frequencies of fl = 100 Hz and fh = 1000 Hz, and for regulators of 0.1 (blue), 0.5 (green) and 1 (red). Although the filters change the phase of the audio input, it is considered that this effect is hardly perceived in normal auditions.

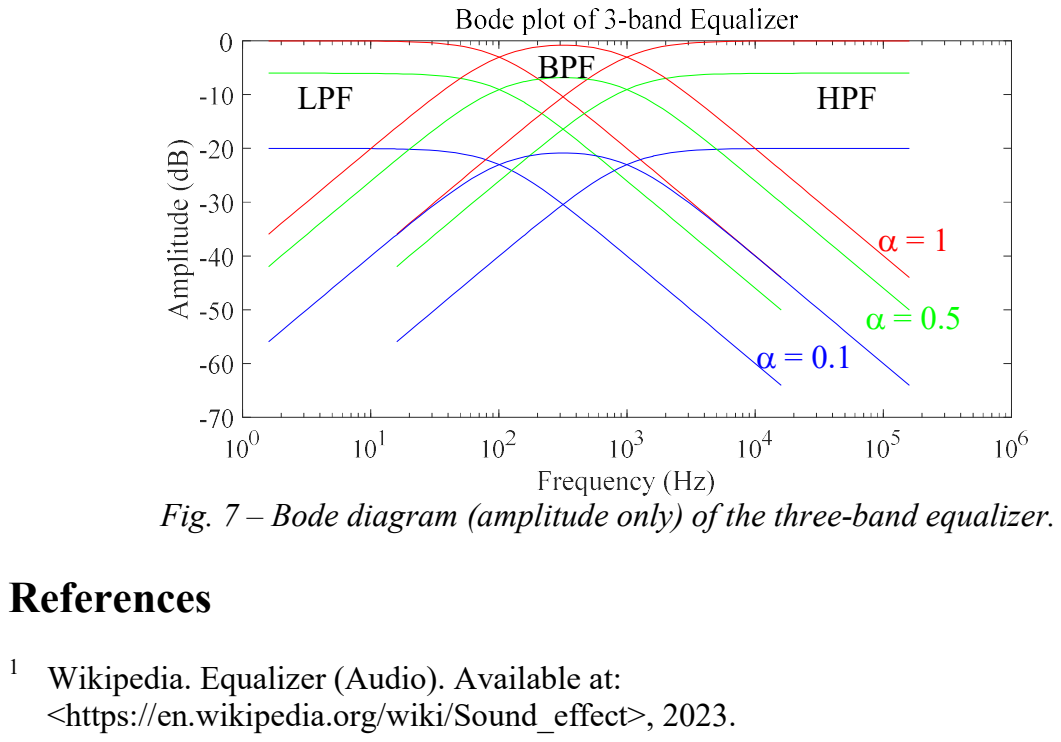
[picture p36: page 6]
References; LPF; BPF; HPF

Fig. 7 – Bode diagram (amplitude only) of the three-band equalizer.

1 Wikipedia. Equalizer (Audio). Available at:
<https://en.wikipedia.org/wiki/Sound_effect>, 2023.
