Guitar-Sound-Processing/GSP/gsp_daisy/Interfaces.md

# Interface Commands

Some additional commands were created to visualize GSP performance.

### Available effects

The command ```cid``` (command id) tells GSP to show the number of available effects in the current version, besides their names and the three letters command identification
	
	cid
	
> ->19<br>
> ->(LevelDetector LVD)<br>
> ->Chorus (CHS)<br>
> ->Compressor CMP<br>
> ->Detune DTN<br>
> ->Equalizer EQZ<br>
> ->FeedbackDelay DFB<br>
> ->FeedbackEcho EFB<br>
> ->FeedforwardDelay DFF<br>
> ->FeedforwardEcho EFF<br>
> ->Limiter LIM<br>
> ->NoiseGate NGT<br>
> ->Octave OCT<br>
> ->Overdrive OVD<br>
> ->Phaser PHR<br>
> ->PitchShifter SFT<br>
> ->Reverber RVB<br>
> ->Tremolo TML<br>
> ->Vibrato VBT<br>
> ->Volume VOL<br>
> ->Wah-wah WAH<br>

### LFFG Profiles

The command ```pfl``` shows the available Low Frequency Function Generator profiles. It also shows which profile depends on frequency (Freq) or duty cycle (Duty), besides the total number of profiles:

	pfl

> -> 11 <br>
> ->Sine Freq<br>
> ->Half_sine Freq<br>
> ->Ramp Freq<br>
> ->Slope Freq<br>
> ->Triangle Freq<br>
> ->Square Freq Duty<br>
> ->Exponential_descend Freq Duty<br>
> ->Exponential_ascend Freq Duty<br>
> ->Expression_pedal<br>
> ->Power_level<br>
> ->Reverse_power <br>

### Verbose

Toggle the verbose (command echoes) on and off (off is default). When verbose is on, GSP echoes any command with leading “<-” string. 

	vbs

By sending this command, GSP answers with

> ->Verbose on

and by sending ```vbs``` again it replies with

> ->Verbose off

When verbose is on, the command ```ovd 0 0.9``` is answered with

> <-ovd 0 0.9 <br>
> ->OVD (1): OFF(0)|ON(1) 0 | Sustain (0.1-1): 0.900 | Tone (0-1): 0.800 | Mixer (0-1): 1.000 | Gain (0-1): 1.000 </br>

### Processing time

Print the processing time at 1 Hz frequency, in percentage of the duty cycle. Small values indicate low processing charges, while high values (close to 90%) indicate overcharging on processor.

	out

The ```out``` command turns on and off the output time (toggle). For instance, this command produces the following output in console:

> ->Duty Time on <br>
> 5.286427<br>
> 5.279953<br>
> 5.289541<br>
> 5.291170<br>
> 5.290229<br>
> 5.290130<br>
> 5.289708<br>
> ->Duty Time off</br>

### Standard reply

This command selects standard printings on console (long format) if *f* is zero, short format with numeric values only if *f* is equal to 1, or muted output if *f* is -1. Any other value or no value at all is considered by GSP as *f* equals to 0. 

	fmt [f]
 		f 	Output reply parameter: standard:0 | short=1 | muted=-1 

The standard output, for instance, is:

> ->OCT (3): OFF(0)|ON(1) 0 | Mixer (0-1): 0.500 | Gain (0-1): 1.000

while the short format is:
 
> ->OCT (3) 0 0.500 1.000 

The short format can be useful for copying and pasting when configuring chain profiles. Care must be taken with *f* = -1, since there will be no information if a wrong command is sent to GSP after ```fmt -1``` is enabled. However, verbose can still work if activated, and unknown command reply (->?) are still shown.

GSP replies to ```fmt``` command without parameter with

> ->FMT: Mute (-1) | Complete (0) | Data only (1): 0

The Mute option affects only the [Effect](https://github.com/Guitar-Sound-Processing/GSP/blob/main/gsp_daisy/Effects.md) and [Expression Pedal](https://github.com/Guitar-Sound-Processing/GSP/blob/main/gsp_daisy/ExprPedal.md) commands. All others, including the [Interface Commands](https://github.com/Guitar-Sound-Processing/GSP/blob/main/gsp_daisy/Interfaces.md) are still printed on terminal.

```fmt 1``` also changes the exhibition of chain commands. For instance, when *f* is zero, the output of the ```all``` command will be:

> ->Inp->(LVD)->CMP->OVD->PHR->OCT->SFT->DTN->WAH->EQZ->CHS->VBT->RVB->DFB->EFB->DFF->EFF->TML->VOL->LIM->NGT->Out->

and when *f* is 1, then

> ->(LVD) CMP OVD PHR OCT SFT DTN WAH EQZ CHS VBT RVB DFB EFB DFF EFF TML VOL LIM NGT
