Guitar-Sound-Processing/GSP/gsp_daisy/Effects/LFFG/LFFG.pdf

## Low Frequency & Function Generator

VCarrara

### Definition

Some guitar effects depend on devices that generate an envelope on the input signal to make it louder or weaker over time. The envelopes may have an attack time (rising time), followed by a steady or flat time and ending with a release time. They are employed in several effects, like Tremolo, Phaser and Chorus. They can increase or decrease the output volume in Tremolo, for instance, or change the pitch in Delay, as in Phaser, Chorus and Vibrato. The envelopes are generated by a low-frequency oscillator (LFO) circuit on analog effects, but this can be easily done digitally. In fact, while analog circuits can only produce static envelopes, like sine or square oscillations, the digital procedures are able to generate several profiles, some of then too difficult to make with analog circuits. That explains why the model of the LFO shown here extends its domain to aboard also function generation and external profiles. Modulation of the audio signal can be done on amplitude, like in Tremolo, for instance, or frequency (pitch) in Chorus and Vibrato, or even in tone, like in Wah-wha.

The functions of the Low Frequency Function Generator (LFFG) can be generically grouped in 3 categories:

- Function Generation with Low-Frequency Oscillator
- Dynamics
- External profile

### Function Generator

The Function Generator (FG) of the Guitar Sound Processing (GSP) can produce several periodic profiles selected by user. Frequency or period can be adjusted, as well as the duty cycle of square waves. The wave profiles are

1) Sine Wave. FG produces positive sine wave, with adjustable frequency. The output amplitude is achieved by

### 1 sin

2

lfo y

where the phase angle is computed as function of the wave frequency , by

- | | t | t 2 int( / 2 ) ,

and, therefore, 0 2. This kind of wave produces a pulsating output. However, the output power is too weak when the amplitude ylfo is small, due to a linear instead of a logarithmic wave power. The amplitude generated by the Sine Wave is shown in Figure 1.

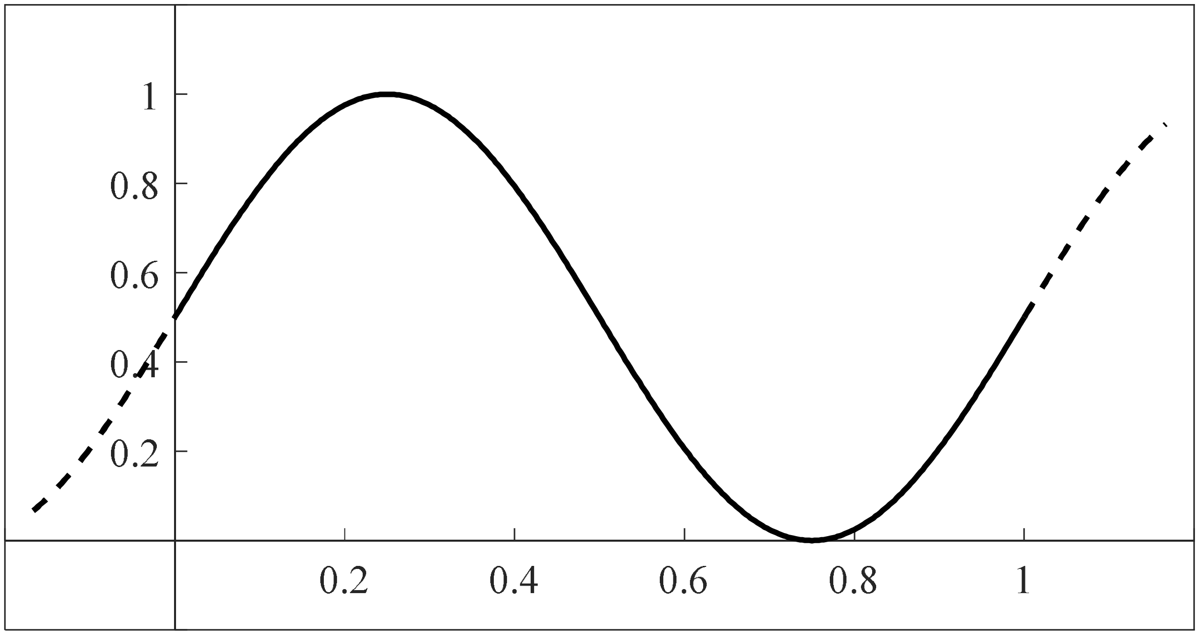
[picture p37: figure]

Fig. 1 – Sine wave profile.

2) Half Sine wave, with adjustable frequency . The wave function is given by
sin( / 2) lfo y | | .

The Half Sine wave shows low amplitude for short time, as can be seen in Figure 2, and this help to correct the power problem found in the Sine Wave.

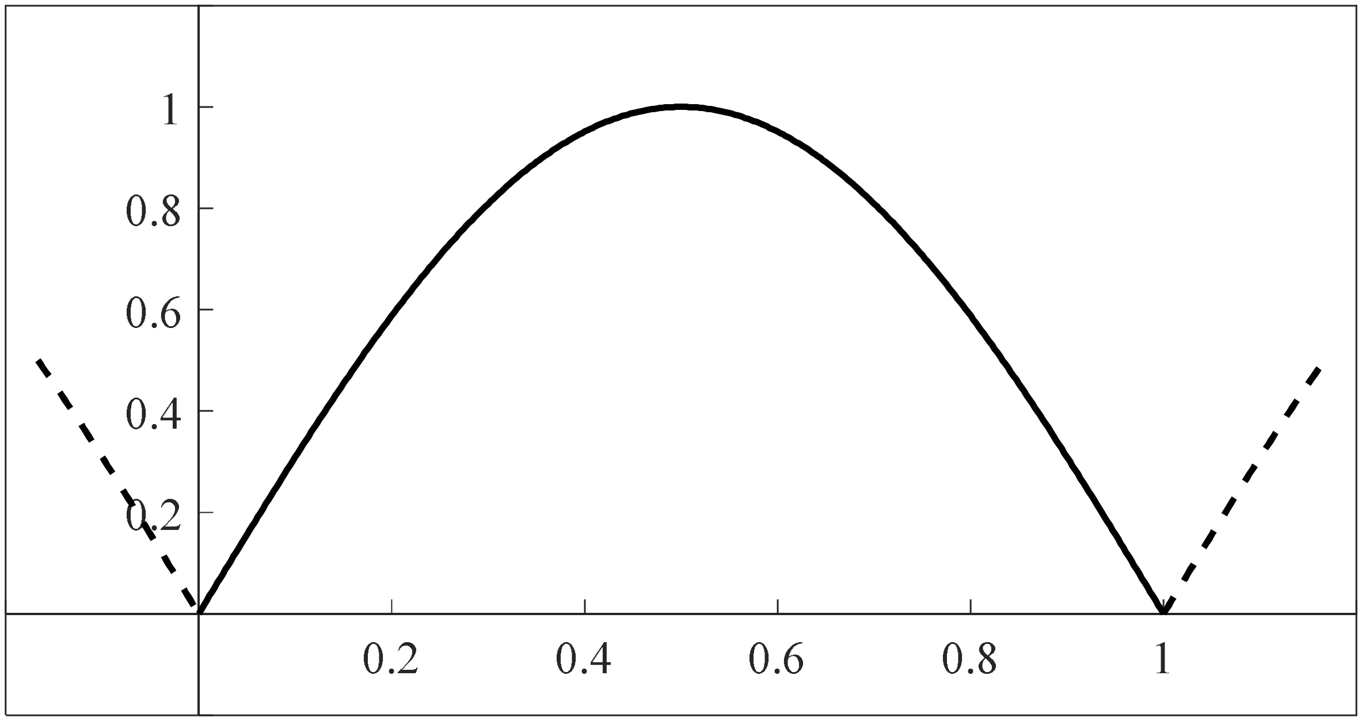
[picture p38: figure]

Fig. 2 – Half sine wave profile.

3) Ramp Wave with adjustable frequency . The wave function is given by

2

lfo y

which produces a saw teeth wave, as shown in Figure 3. This kind of wave can be used to simulate time inverted sounds.

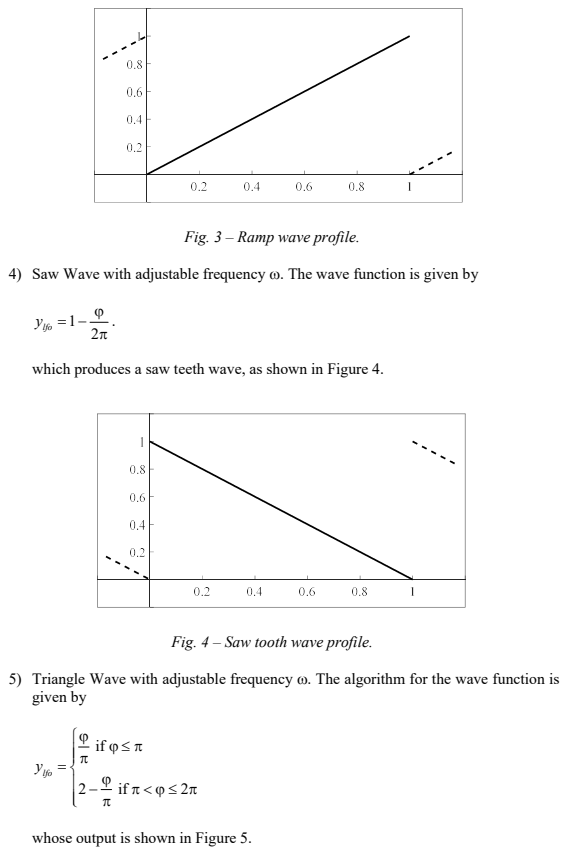
[picture p39: page 3]
lfo y

Fig. 3 – Ramp wave profile.

4) Saw Wave with adjustable frequency . The wave function is given by

which produces a saw teeth wave, as shown in Figure 4.

Fig. 4 – Saw tooth wave profile.

5) Triangle Wave with adjustable frequency . The algorithm for the wave function is
given by

whose output is shown in Figure 5.

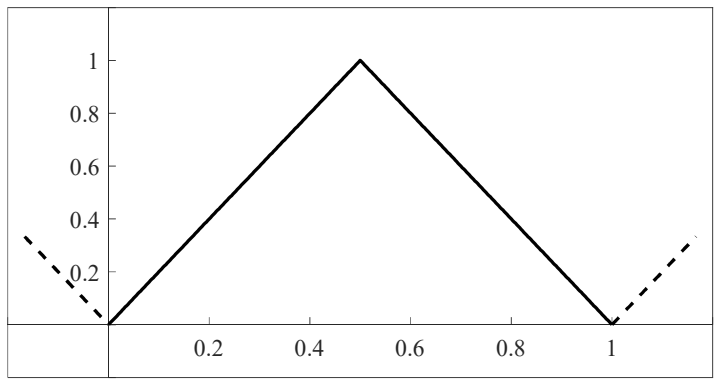
[picture p40: figure]

Fig. 5 – Triangle wave profile.

6) Square Wave with adjustable frequency and duty cycle . The algorithm for the wave function is given by

### 1 if 0 if 2 lfo y

whose output is shown in Figure 6.

1 0.8 0.6 0.4 0.2

| 0.2 0.4 0.6 0.8 1

Fig. 6 – Square wave profile.

7) Exponential Decay with adjustable frequency and decay rate . The algorithm for the wave function is given by
2 | 2 1 e | e

g
lfo y

where g is a variable related to the attack gain, and was fixed in g = 256. The decay rate changes the release time of this LFO, as can be seen in the Figure 7, for equal to 1 (blue), 4 (black) and 16 (red). The exponential decay mimics the envelope of a damped vibrating string.

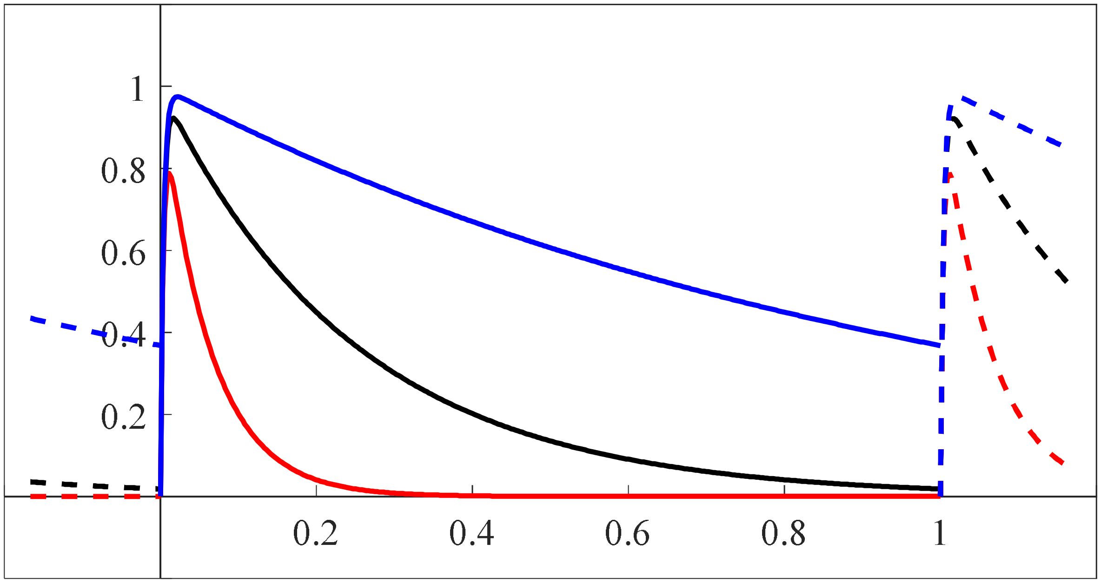
[picture p41: figure]

Fig. 7 – Exponential decay wave profile.

8) Exponential Wave with adjustable frequency and slope rate . This envelope is the reverse of the Exponential Decay. The algorithm for the wave function is given by

1 1
2 | 2 1 e | e

g
lfo y

The Exponential Wave simulates the time reverse envelope of a vibrating string. The slope rate changes the attack time, as can be seen in the Figure 8, for equal to 1 (blue), 4 (black) and 16 (red).

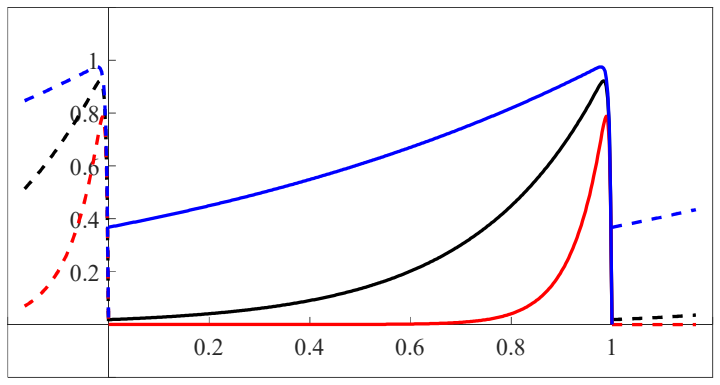
[picture p42: figure]

Fig. 8 – Exponential wave profile.

### Dynamics

Some effects depend on the input envelope or the input power. For example, some sustain pedals increase the output gain whenever the input level decreases, therefore maintaining the strength of the guitar sound. Compressors and expanders also make use of the input power to adjust the output level. As the input power changes within long time intervals, it can be used to envelope any input signal that uses LFO, such as Chorus, Phaser, Tremolo, etc, and even an automatic Wah-wah. Two kinds of dynamics are available: the Level Detector and the Reverse Level Detector.

1) Level Detector. The procedure computes the input power exactly in the same way as the Compressor effect does (see Compressor documentation for more details). However, instead using the Compressor to generate the LFO envelope, the same algorithm of level detection of Compressor was employed. This procedure runs separately from any effect and before processing any input audio signal.

If x(k) is the amplitude of the input audio at instant k, then the Level Detector is computed by

( ) | ( ) L x k | x k
y k | x k | y k | x k 1 | 1 ( ) max | ( ), | ( | 1) (1 | ) ( ) | | L | R | R | L |

and then a first-order low-pass filter is applied to the input level, resulting

1

( ) | ( | 1) (1 | ) ( ) lfo | A lfo | A y k | y k | y k |

where A and R are the attack and release coefficients, respectively, computed by

1
e

A sf
A

and

1
e

R sf
R

for a discrete filter, and such that fs is the sampling rate, and A and R are the attack and release time constants.

2) Reverse Level Detector. Together with the Level Detector, GSP also provides the Reverse Level Detector, which is simply given by
[ ] | [ ] lfo | mx | lfo y k | M | y k | | ,

where Mmx is the maximum level that an input signal can reach, and ylfo is the Level Detector output. The Reverse Level Detector can be used to model a sustain effect.

### External profile

Whenever the preceding functions fail, the External Profile is the final solution. The envelope level is provided by an external source through a digital serial line, at 10 Hz rate. Several channels are available to provide up to 8 input envelopes. Each one can be obtained by a simple Expression Pedal, or by customized algorithms. More information is available in Expression Pedal Linkage. The main use of this kind of envelope is to control the output level with an Expression Pedal (or Volume pedal), to provide the modulation for a Wah-Wah, for instance. However, any other effect that requires the LFO can be attached to an External Profile, like Chorus, Phaser, Vibrato and Tremolo, among others. The External profile computes the output gain by

g h | h (1 | )

where h is the ADC data from the Expression Pedal, and is the threshold, which can be adjusted by the effect command. The minimum output gain is always equals to the threshold. Some Expression Pedals have a bias potentiometer to adjust the minimum gain. Therefore the threshold parameter mimics this potentiometer. Figure 1 shows the LFO level as function of the normalized potentiometer data, for thresholds going from 0% up to 100%. However, the potentiometer data can be affected by several factors due to Expression Pedal brand and type. Figure 2 shows the output of the Boss Expression Pedal as function of the pedal excursion, for three values of the bias potentiometer. As can be easily seen in this picture, this pedal has large dead bands on both extremities, leaving only around 45% for the total excursion to adjust the output level.

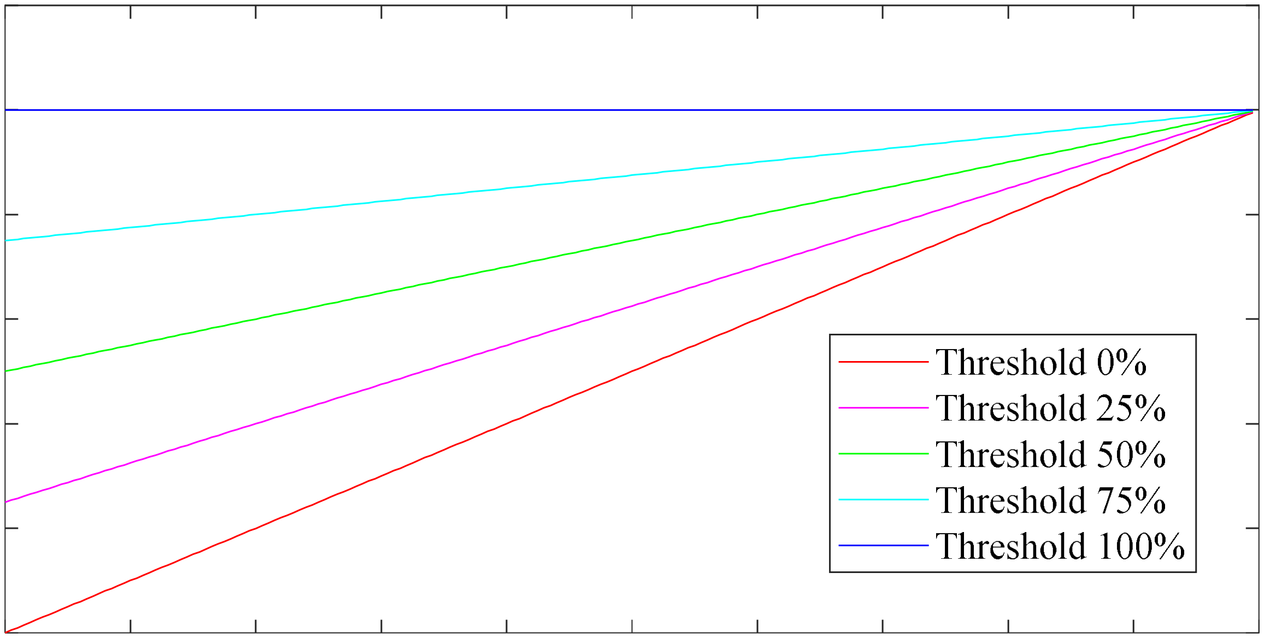
[picture p43: figure]

Fig. 1 – LFO level as function of the Expression Pedal input for different thresholds.

0 | 0.1 | 0.2 | 0.3 | 0.4 | 0.5 | 0.6 | 0.7 | 0.8 | 0.9 | 1
Expression Pedal excursion

0

0.2

0.4

0.6

0.8

1

1.2 Expression Pedal level | Bias potentiometer = 0%

Bias potentiometer = 50%
Bias potentiometer = 100%

Fig. 2 – Real Expression Pedal level as function of the excursion and potentiometer bias.

### LFFG class

The LFFG class can be included as member in any effect class. Its methods are:

- void | Init(uint32_t sampling_rate);
- void | SetProfile(uint8_t prof);
- void | SetPeriod(uint32_t prd);
- void | SetFrequency(float freq);
- void | SetDutyCycle(float duty_cycle);
- void | SetGain(uint32_t gain);
- uint32_t | GetAmplitude();
- uint32_t | GetValue();

and the enumerator

enum lfo_wave
{
LFO_SIN, | (Sine wave)
LFO_HALFSINE, | (Half sine wave)
LFO_RAMP, | (Ramp wave)
LFO_SAW, | (Saw wave)
LFO_TRIANGLE, | (Triangle wave)
LFO_SQUARE, | (Square wave)
LFO_EXPDECREASE, (Exponential decay) LFO_EXPINCREASE, (Exponential wave)
LFO_EXTERNAL, | (External profile - potentiometer)
LFO_LEVEL, | (Level detector)
LFO_REVERSE_LEVEL, (Reverse level detector)
LFO_LAST | (None)
}

LFFG class need to be initialized with Init() method before using it, where sampling_rate is the selected sampling rate of the audio signal. All LFFG profiles use lookup tables (arrays) to previously store the modulation amplitude, with 512 time intervals in each cycle period. No interpolation is made on retrieving the output level, so discrete changes may occur. In the current version this value can only be modified by program recompilation. The default values after initialization of this class are LFO_HALFSINE profile, period TLFO equal to 500 milliseconds, and duty cycle of 50%. The class properties are configurable with the methods:

- SetProfile(uint8_t profile)
Function to select the desired LFFG profile from the available function generators. profile can be any of the lfo_wave enumerator values.
- SetPeriod(uint32_t prd)
To set the LFFG period TLFO = 2/ in milliseconds (between 100 and 5000) if applicable
- SetFrequency(float freq)

To set the LFFG frequency in Hz (between 0.2 to 10 Hz) if applicable, or the channel of the Expression Pedal channel (from 0 to 100), in the LFO_EXTERNAL profile.
- SetDutyCycle(float duty_cycle)
To set the LFFG duty cycle in percentage of the LFFG period (between 0 and 100%), if applicable, or the threshold of the LFO_EXTERNAL profile.

Additionally, if LFO_EXTERNAL profile is selected, LFFG counts with a function to set the output amplitude after reading the potentiometer level:

- SetGain(uint32_t gain)
To set the LFFG output in GetValue() method. gain must be scaled to the 0 to 65532 interval.

LFFG has only two methods to retrieve information:

- uint32_t GetAmplitude()
This function gets the maximum amplitude of the output modulation level, presently equal to 65532.
- uint32_t GetValue()
This function returns with the modulation level, according with the selected profile, in the range 0 to 65532, at the time it is called. Note, however, that GetValue() must be called at the same frequency as the audio sampling rate, since it is time dependant, and any timer function can be cumbersome in some way, both for processing time or timer overflow. Therefore it was considered preferable to increment the phase angle at each GetValue() call by /fs, but this requires calling this function at fs rate. Of course the effects that require LFFG provide this action.
