Guitar-Sound-Processing/GSP/gsp_daisy/Effects/Reverber/Reverb.pdf

## Reverber

VCarrara

### Definition

Reverberation is a natural process where sound reflects on walls, surfaces and objects inside a room, and persists even after the original sound has faded. The reflections make the sound to decay, as well as to change its frequency spectra¹
. Small rooms create highly damped reverberation, whereas large rooms as gymnasium or caves sustain the reverberation for longer times.

The reverberation can be artificially produced using analog (plate, spring or Bucket Brigade Devices), or digital technologies²

### Reverber

In a digital Reverber the audio reflections are simulated by delay lines, either by Feedforward Delay, Tapped Delay Lines, or Feedback Delay Networks. Whichever be the alternative, the multiple delayed signals must be filtered to change the spectrum and to avoid excessive presence of high frequencies on the output.

Some tests were made with well known Reverber algorithms, like the Freeverb, a single feedback delay line and a Feedback Delay Network (FDN). Best results come from Freeverb; however it is very process time consuming, and requires several large buffers to store the delay lines from the all-pass filters. Probably Freeverb can run on microcontrollers as single effect, but there is no evidence that it can share processing time in a multi-effect pedal. The single feedback delay line was already modeled in the Feedback Delay effect, but it lacks the typical reverberation of large rooms, due the missing filters. On the other hand, FDN produces good reverberations with large echo density, and requires modesty computation resources. Therefore FDN Reverber was a natural choice.

The selected FDN architecture was suggested by JOS³
in his homepage, which is presented in Figure 1. There is just one input for all lines of the FDN, and the output lines are combined linearly. Instead of having multiple feedback lines, the FDN Reverber mixes them linearly by means of a matrix product, which increases reflections density. In order to reduce instability and the high frequency harmonics introduced by the feedback lines, the feedback gains gi are replaced by low-pass filters. The input gains bi provides the necessary adjustment of the reverberation amplitude as function of the delay times. As well as the feedback gains, the output ci gains can also be replaced by a spectral band equalizer in order to achieve control over the reverberation process. Other modification introduced by JOS in the Reverber design is to mix the FDN output to the dry signal (input) weighted by a d gain, as can be seen in Figure 1.

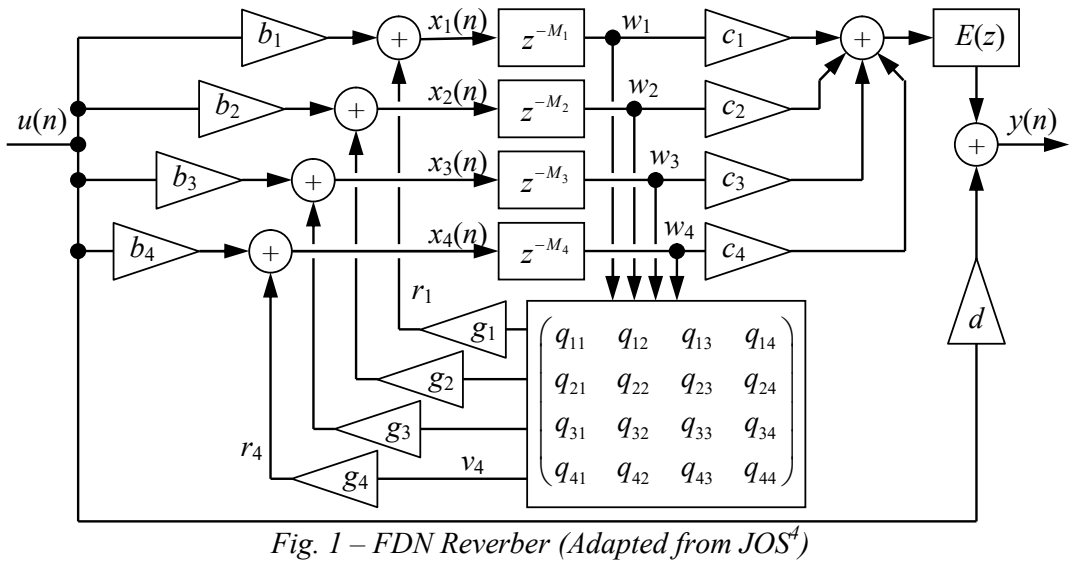
[picture p44: figure]

Fig. 1 – FDN Reverber (Adapted from JOS⁴

The difference equation of the feedback loop can be formulated with

1 | 1 | 1 | 1 11 | 12 | 13 | 14
2 | 2 | 2 | 2 21 | 22 | 23 | 24
3 | 3 | 3 | 3 31 | 32 | 33 | 34
4 | 4 | 4 | 4 41 | 42 | 43 | 44
( ) | 0 | 0 | 0 | ( | ) 1
( ) | 0 | 0 | 0 | ( | ) 1
( )
( ) | 0 | 0 | 0 | ( | ) 1
( ) | 0 | 0 | 0 | ( | ) 1
x n | g | x n M q | q | q | q
x n | g | x n M q | q | q | q
b | u n
x n | g | x n M q | q | q | q
x n | g | x n M q | q | q | q

,

and the transfer function of this FDN is given by

X | u | GQD X ( ) | ( ) | ( ) ( ) z | b n | z | z |

in which

1

2

3

4

0 | 0 | 0
0 | 0 | 0 ( )
0 | 0 | 0
0 | 0 | 0

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
Feedback matrix

Julios Orion Smith III⁴
emphasizes that the feedback matrix A is simpler when its dimension is a multiple of 2 (2, 4, 8, 16, ...) because the coefficients are unitary and, therefore, it is not necessary to multiply the inputs by non integer coefficients. It was adopted then 4 FDN lines for the Reverber presented here. Moreover, this matrix must be orthogonal, such as, for example, a Hadamard matrix⁴
. JOS also points out that the delayed signals can be replaced by a comb filters, such as FBCF, for example. The matrices suggested by JOS are:

| 0 1 1 | 0
1 | 1 0 0 | 1
2 1 0 0 | 1
0 1 | 1 0

A g

which is stable if g is constant. One of the several Hadamard feedback matrix that can be used in FDN Reverber is given by

4

1 1 | 1 | 1
1 1 | 1 1 | 1
2 1 1 | 1 | 1
1 | 1 | 1 1

H

Yet another possibility is the Householder matrix, whose main diagonal elements are positive, while the elements off diagonal are negative:

4

1 | 1 | 1 | 1
1 1 1 | 1 | 1
2 1 | 1 1 | 1
1 | 1 | 1 1

A

On tests the Hadamard H4 matrix got a better reverberation than the others, but similar to the standard A matrix.

Delay time

High reverberation density can be achieved when all the time delays Mi are mutually primes. Of course the delay times are related to the size of a reverberation room; the larger the room, the longer the reverberation time. JOS presents some useful relations to compute the Mi delays as function of the mean free path of the sound for a specific room size. Anyway, good reverberations were achieved in tests with regular delay times ranging from

### 5 to 15 milliseconds, or with number of samples between 650 up to 2000. Since the

reverberation suffers from phasing for low Mi and echoes when high values are used, it was adopted a fixed values for the Mi set: 653, 859, 1303 and 1987.

Low Pass Filter

As commented before, JOS states that the gi gains provide the necessary damping of the reverberation. However, as the damping time depends on audio frequency, he suggests that gi be replaced by a Low-Pass Filter H(z) in the feedback delay line. In order to achieve the same damping time for different delay times, the low pass filter must also be function of the delay time, and therefore

1

( )
1

i
i
i

g H z
p z

,

which corresponds to the difference equation

( ) | ( | 1) | ( ) i | i i | i i r n | p r n | g v n | | ,

such that

0

0

i | i
i | i

M M

i | M | M

R R
p
R R

and

0

0

2
i | i
| i | i M M
i | M | M

R R
g
R R

in which the constants 0

Mi R and Mi R depend on the delay Mi:

60 3 | / (0)
0 | 10 M | M T t i | i R

and

60 3 | / ( / ) 10 M | M T t | T i | i R

,

where t60() is the time the signal amplitude takes to decrease 60dB from unity at angular rate (frequency) . Thus t60(0) means a the damping time for null frequency, and /T is the frequency at half of the sampling rate T, which is normally 22 kHz. Reasonable values for these times result with t60(0) twenty times greater than t60(/T), or t60(0) = 20 t60(/T). By making

60

60

( / )
(0)

t T
t

and adopting = 1/20, the only parameter to be adjusted will be t60(0), which can vary from 0.1 second (almost no reverberation) up to 10 seconds (large reverberation).

Tonal corrector

JOS also says that E(z), shown in Figure 1, is a low-order filter, called tonal corrector, that equalizes the total energy as function of the frequency band. The tonal corrector block diagram is shown in Figure 2, whose transfer function is given by

1 1
( )
1

b z E z
b

,

in which

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
- x(n) | y(n)

1

### 1 b

Fig. 2 – Tonal corretor (Adapted from JOS⁴ )

and such that = . However, with = 1/20 (see above) the reverberation still sounds a little bit metallic, indicating the presence of high frequencies on output. Better results were obtained if = 10. The difference equation of the tonal corrector is

(1 | ) ( ) | ( ) | ( | 1) | | | b y n | x n b x n | ,

where x(n) is the input to the tonal corrector and y(n) its output.

Algorithm

The algorithm for the FDN Reverber is therefore

1) Create circular buffers xi with dimension M = max(Mi) (i = 1, …, 4) to store the delay lines, and initialize xi with zeros. Make Mi = 653, 859, 1303, and 1987, for sampling rate f = 44100, and T = 1/f. Make = 1/20, bi = 1 and ci = 1, for i = 1, …, 4.
2) Given the decay time t60(0) and the feedforward gain d, compute
60 | 60 t | T | t ( / ) | (0) | | ,

and the four values of

60 3 | / (0)
0 | 10 M | M T t i | i R
- | ,

and

60 3 | / ( / ) 10 M | M T t | T i | i R

3) Now compute also the four values of

0

0

i | i
i | i

M M

i | M | M

R R
p
R R

and

0

0

2
i | i
| i | i M M
i | M | M

R R
g
R R

4) Make = 10 and compute

1
1

b

5) Now implement the delay lines:
( ) | ( | ) w n | x n M i | i | i | | ,

and the matrix product

1 | 1 | 2 | 3 | 4
2 | 1 | 2 | 3 | 4
3 | 1 | 2 | 3 | 4
4 | 1 | 2 | 3 | 4
( ) | ( ) | ( ) | ( ) | ( )
( ) | ( ) | ( ) | ( ) | ( )
( ) | ( ) | ( ) | ( ) | ( )
( ) | ( ) | ( ) | ( ) | ( )
v n | w n w n w n w n
v n | w n w n w n w n
v n | w n w n w n w n
v n | w n w n w n w n

,

6) Apply the Low Pass Filter Hi:
( ) | ( | 1) 0.5 | ( ) i | i i | i i r n | p r n | g v n | | ,
7) Store the value of xi(n) in the buffer
( ) | ( ) | ( ) i | i | i x n | b u n r n | | ,
8) Apply the c gain and the tonal corrector
1 | 2 | 3 | 4 s n | c w n w n w n | w n ( ) | [ ( ) | ( ) | ( ) | ( )] | | | | ,

1
( ) | ( ) | ( | 1)
1 1

b
n | s n | s n
b | b
- ,
9) Add the dry signal to the output
y n | n d u n ( ) | ( ) | ( ) | | ,

### References

1 Wikipedia. Reverberation. Available at: <https://en.wikipedia.org/wiki/Reverberation>, 2023.

2 Wikipedia. Reverb effect. Available at: <https://en.wikipedia.org/wiki/Reverb_effect>, 2023.

### 3 Smith III, J. O. CCRMA Home Page. Center for Computer Research in Music and

Acoustics (CCRMA), Stanford University, Stanford (CA). Available at: <https://ccrma.stanford.edu/~jos/Welcome.html>, 2023.

### 4 Smith III, J. O. FDN Reverberation. Center for Computer Research in Music and

Acoustics (CCRMA), Stanford University, Stanford (CA). Available at: <https://ccrma.stanford.edu/~jos/pasp/FDN_Reverberation.html>, 2023.
