Guitar-Sound-Processing/GSP/gsp_daisy/Effects/Noise_Gate/Noise_Gate.pdf

## Noise Gate

VCarrara

### Definition

Effects that need high amplification on output, like, for instance, Compressor, Sustain, Overdrive and Distortion, among others, produce as well high noises. Normally this noise are unheard because the instrument volume over exceed it. When the instrument is silent, however, the noise becomes audible and also cumbersome. That’s when a Noise Gate can help.

The Noise Gate (NG) monitors the audio level, and when it detects that the level falls behind a threshold, it mutes the output. No sound is audible since, unless the instrument starts to play again.

### Noise Gate Model

A Noise Gate needs a level detector and, for that, it was chosen the level detector of the Compressor¹
model, which is reproduced here.

Given the input at sampled time n, x(n), the best approach to compute the input level yL(n) is achieved with the level detector in the linear domain, and since the threshold for the input can be neglected, the input level is computed by

( ) | ( ) L x n | x n

Next step consists in smoothing the input level. Good results in both compression quality and fast algorithm were obtained with the decoupled smooth peak detector¹ which
responds quickly when the input level rises, but decreases slowly when the input level fades:
y n | x n | y n | x n 1 | 1 ( ) max | ( ), | ( | 1) (1 | ) ( ) | | L | R | R | L |

So the smoothed output level becomes

1

( ) | ( | 1) (1 | ) ( ) L | A L | A y n | y n | y n |

where A and R are the low-pass filter attack and release parameters, respectively, obtained from

1
e

A sf
A

and

1
e

R sf
R

in which A is the attack time, R is the release time and fs is the sampler frequency.

Let Tng be the Noise Gate threshold and gng the output gain. Then the NG function is given by

0, if ( )
( ) 1, if ( ) L ng
G
| L ng

y n T
y n
y n T

and noiseless output is computed by

( ) | ( ) ( ) ng | G y n | g y n x n | .

Figure 1 presents the output function yG of the Noise Gate as function of the input level yL for a threshold parameter of 0.1.

Fig. 1 – Output level of the Noise Gate for threshold equal to 0.1.

It can be noted that the GSP main loop has its own level detector, which is used by the Low Frequency Function Generator (refers to specific documentation). So, NG computations could be simplified case it recovers yL from the GSP level detector, but, for that, both should share the same attack and release times, which could compromise the necessary independence between effect modules.

The adjustable parameters of the Noise Gate are, therefore: the threshold Tng, the attack and release times (or number of samples) A and R, and the output gain gng.

### References

1
Giannoulis, D.; Massberg, M.; Reiss, J. Digital Dynamic Range Compressor Design – A Tutorial and Analysis. Journal Audio Engineering Society, Vol. 60, No. 6, June 2012.
