Guitar-Sound-Processing/GSP/gsp_daisy/Effects/Level_Detector/Level_Detector.pdf

## Level Detector

VCarrara

### Definition

The Level Detector is a small code placed before any effect that aims to compute the input audio level. The level can then be used by any effect with LFFG (Low Frequency and Function Generator) configured with LFO_LEVEL or LFO_REVERSE_LEVEL to modulate a specific parameter, like the Wah Wah or Tremolo, for instance. The effects that can be affected by Level Detector are

- Chorus (chr)
- Phaser (phr)
- Tremolo (tml)
- Vibrato (vbt)
- Volume (vol)
- Wahwah (wah)

### Level Detector

The adopted algorithm for the Level Detector is exactly the same of the Compressor¹,2 effect, except that it does not compress the input audio. The model for the Level Detector was extracted from Compressor documentation and is reproduced here.

Given the input at sampled time n, xL[n], the best approach to compute the input level yL[n] is achieved with the decoupled smooth peak detector³
which responds quickly when the input level rises, but decreases slowly when the input level fades:
y n | x n | y n | x n 1 | 1 [ ] max | [ ], | [ | 1] (1 | ) [ ] | | L | R | R | L |

So the smoothed output level becomes

1

[ ] | [ | 1] (1 | ) [ ] L | A L | A y n | y n | y n |

where A and R are the low-pass filter attack and release parameters, respectively, obtained from

1
e

A sf
A

and

1
e

R sf
R

in which A is the attack time and R is the release time.

### References

1
Wikipedia. Dynamic Range Compression. Available at: <https://en.wikipedia.org/wiki/Dynamic_range_compression>, 2023.

2
McNally, G. W. Dinamic Range Control of Digital Audio Signals. Journal of the Audio Engineering Society, Vol. 32, No. 5, May 1984.

3
Giannoulis, D.; Massberg, M.; Reiss, J. Digital Dynamic Range Compressor Design – A Tutorial and Analysis. Journal Audio Engineering Society, Vol. 60, No. 6, June 2012.
