Guitar-Sound-Processing/GSP/gsp_daisy/Effects/Compressor/Compressor.pdf

## Compressor

VCarrara

### Definition

Dynamic range compression or simply compression is the reduction of the dynamic range of an audio signal to avoid unintentional fluctuation in the dynamics (volume, for instance). According with Wikipedia¹
, “Compression is an audio signal processing operation that reduces the volume of loud sounds or amplifies quiet sounds, thus reducing or compressing an audio signal's dynamic range. Compression is commonly used in sound recording and reproduction, broadcasting, live sound reinforcement and in some instrument amplifiers.”

Depending on where the controlled gain acts on the input signal, the compressor can be of downward or upward type, as shown in Figure 1. Wikipedia also clarifies that

“Downward compression reduces the volume of loud sounds above a certain threshold. The quiet sounds below the threshold remain unaffected. This is the most common type of compressor. A limiter can be thought of as an extreme form of downward compression as it compresses the sounds over the threshold especially hard.

Upward compression increases the volume of quiet sounds below a certain threshold. The louder sounds above the threshold remain unaffected.”

The opposite of compression is named expansion (sometimes also called expander or even “expandor”). Expansion increases the dynamic range of the audio signal and also comes in two types, downward and upward, as can be seen in Figure 2.

“Downward expansion makes the quiet sounds below the threshold even quieter. A noise gate can be thought of as an extreme form of downward expansion as the noise gate make the quiet sounds (for instance: noise) quieter or even silent, depending on the floor setting.

Upward expansion makes the louder sounds above the threshold even louder.”

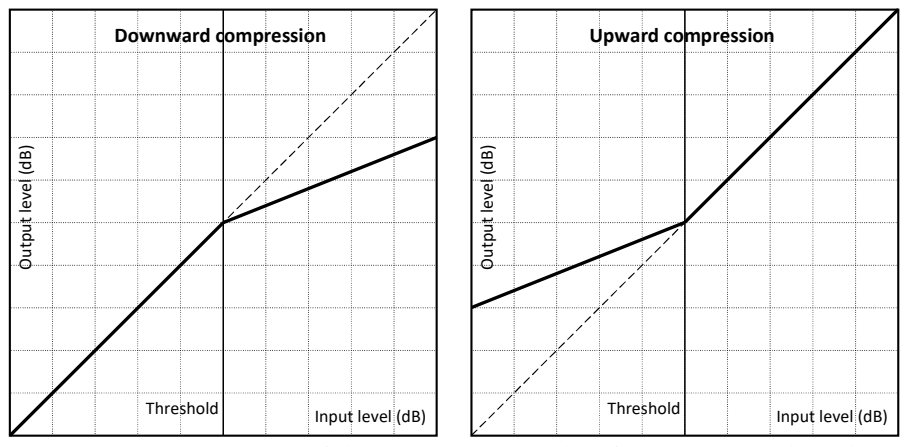
[picture p47: figure]
Input level (dB) Output level (dB⁾; Downward compression; Threshold; Output level (dB⁾; Upward compression; Input level (dB) Threshold

Fig. 1 – Compression of the type Downward (left) and Upward (right)

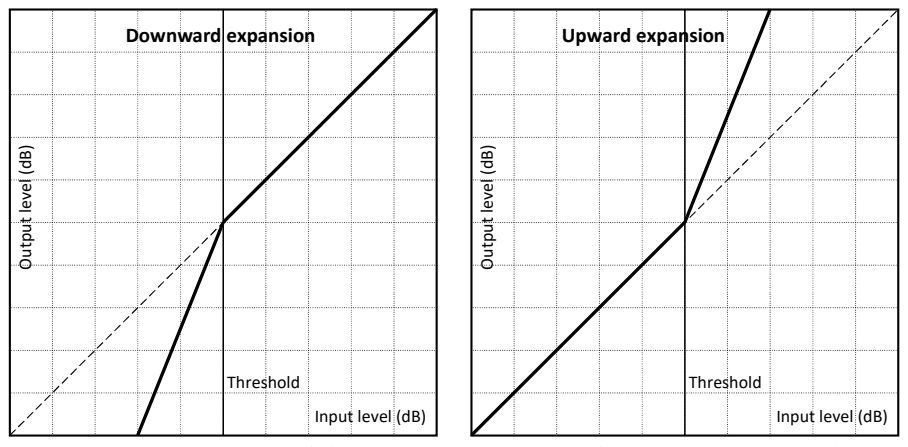
[picture p48: figure]
Output level (dB); Downward expansion; Input level (dB); Threshold; Output level (dB⁾; Upward expansion

Fig. 2 – Expansion of the type Downward (left) and Upward (right)

More powerful compressors can be achieved by including threshold for several paths in the expansion, compression, and limiter²
. Compressor can also be used to increase sustain.

### Compressor

The adopted compressor model was presented by Giannoulis and others³
with the
formulation of a downward compression, and reproduced here.

Given the input at sampled time n, x[n], the best approach to compute the input level is achieved with the level detector in the linear domain but including the threshold level. In this case the input level is computed by

/20 [ ] | [ ] | 10T
L x n | x n |

in which T is the selected threshold in dB, as seen in Figures 1 and 2.

Next step consists in smoothing the input level. Good results in both compression quality and fast algorithm were obtained with the decoupled smooth peak detector³ which
responds quickly when the input level rises, but decreases slowly when the input level fades:
y n | x n | y n | x n 1 | 1 [ ] max | [ ], | [ | 1] (1 | ) [ ] | | L | R | R | L |

So the smoothed output level becomes

1

[ ] | [ | 1] (1 | ) [ ] L | A L | A y n | y n | y n |

where A and R are the low-pass filter attack and release parameters, respectively, obtained from

1
e

A sf
A

and

1
e

R sf
R

in which A is the attack time and R is the release time.

Giannoulis and others³
suggests two different gain profiles for the compressor: the soft and the hard knee, as depicted in Figure 3. Soft knee gives a smooth transition between the gain ranges, while the gain in the hard knee changes abruptly on the threshold. Due to real time requirements, it was chosen the hard knee, with leads to the compressor gain given by
/ 20
10 [ ] 20log | [ ] 10T
G | L x n | y n | | ,

in dB units. By placing the Level Detector before the Gain Computer, as suggested by Giannoulis and others³
, the output level can now be computed with

, for

, for

G G

G G
G
x | x | T
y | x | T T | x | T
R

,

in which R is the compression rate (normally around 20 dB).

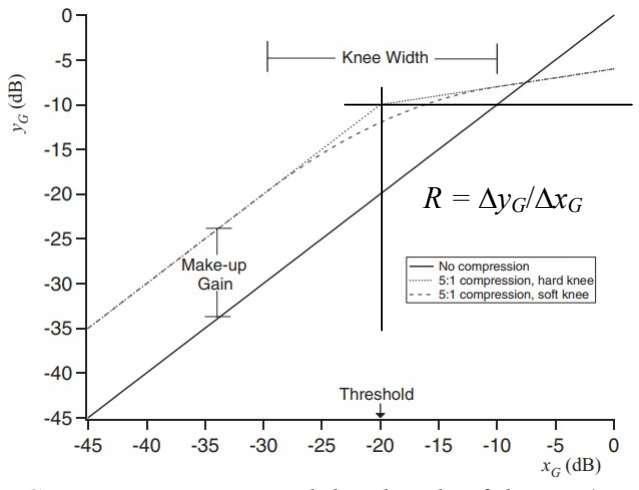
[picture p49: figure]

Fig. 3 – Compression curve with hard and soft knees. (Source: ³ )

The compressor gain can be obtained in dB units by

[ ] | [ ] | [ ] dB | G | G c n | y n x n | | ,

and converting it to linear scale, it gives

[ ]
20 [ ] 10
dB c | n
c n | .

The output level (dB) is simply given by

[ ] | [ ] | [ ] dB | dB | dB y n | x n c n M | |

where M (dB) is the Make-up gain that increases the output level of quiet sounds, and therefore the compressor output yields

y n | M c n x n [ ] | [ ] [ ] | .

Some procedures were taken to increase algorithm speed, like adopting look-up tables to perform logarithm and exponential functions, beside variables scaling to allow integer math operators.

### References

1
Wikipedia. Dynamic Range Compression. Available at: <https://en.wikipedia.org/wiki/Dynamic_range_compression>, 2023.

2
McNally, G. W. Dinamic Range Control of Digital Audio Signals. Journal of the Audio Engineering Society, Vol. 32, No. 5, May 1984.

3
Giannoulis, D.; Massberg, M.; Reiss, J. Digital Dynamic Range Compressor Design – A Tutorial and Analysis. Journal Audio Engineering Society, Vol. 60, No. 6, June 2012.
