Guitar-Sound-Processing/GSP/gsp_application/gsp_app/android/src/main/ic_launcher-playstore.png

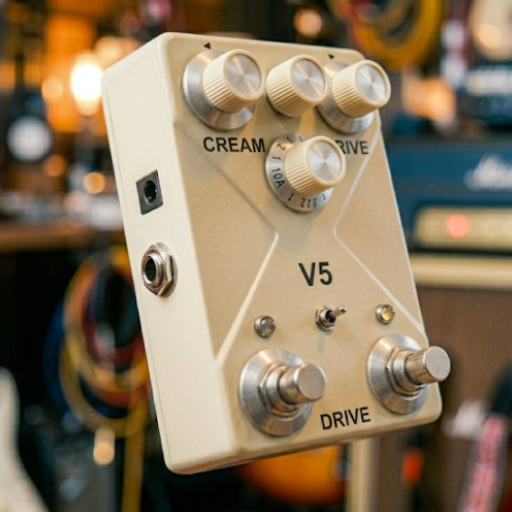
gsp_application/gsp_app/android/src/main/ic_launcher-playstore.png
