Guitar-Sound-Processing/GSP/resources/driver_board_pcb.png

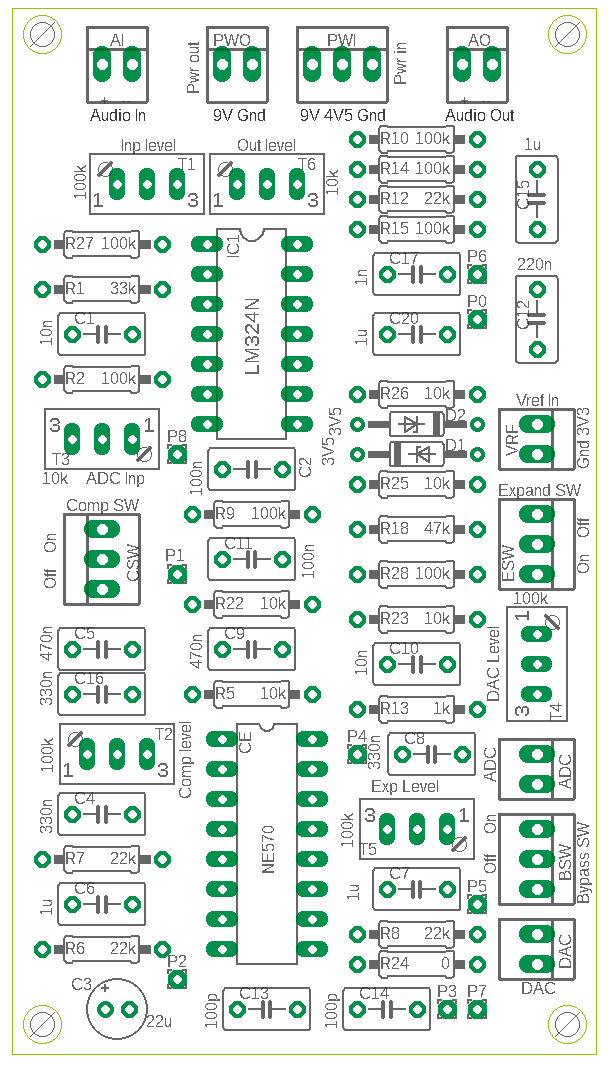
resources/driver_board_pcb.png
