Guitar-Sound-Processing/GSP/resources/ds_interfaces.jpg

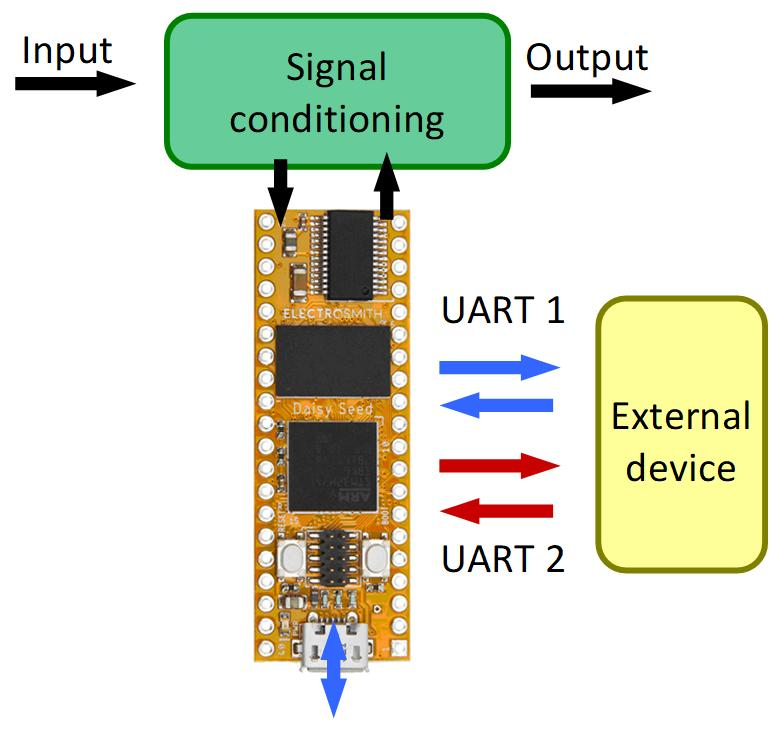
resources/ds_interfaces.jpg
