Guitar-Sound-Processing/GSP/resources/gsp_arquit.jpg

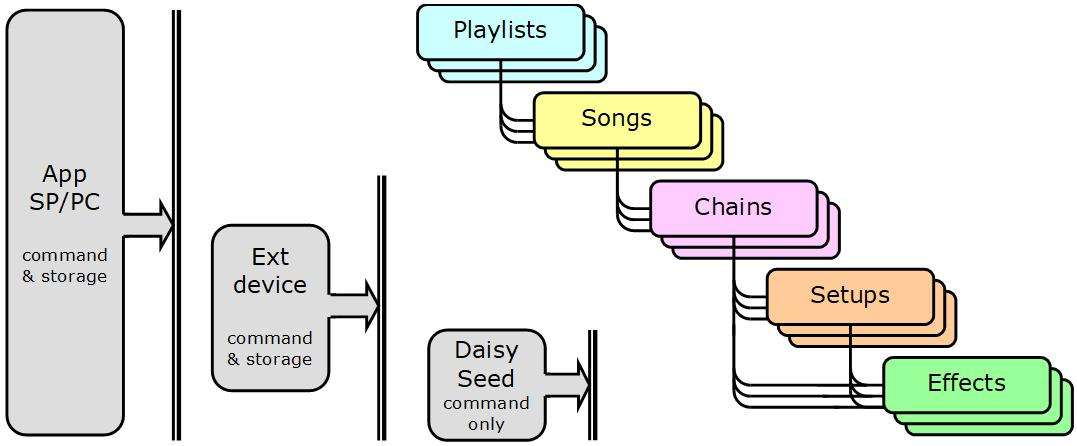
resources/gsp_arquit.jpg
