Guitar-Sound-Processing/GSP/resources/pot_data.png

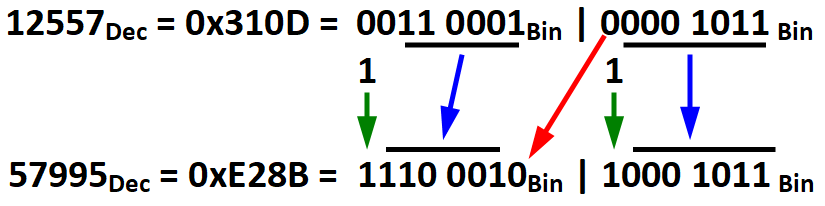
resources/pot_data.png
