Guitar-Sound-Processing/GSP/gsp_daisy/src/lfo.h

#pragma once
#ifndef GSP_LFO
#define GSP_LFO

#define     PROFILES_NUMBER  11       
enum lfo_wave
{
	LFO_SIN, 			// 0 - Sine <0:2*pi>
	LFO_HALFSINE, 		// 1 - Half sine <0:pi>
	LFO_RAMP,			// 2 - Saw tooth /|/|/|
	LFO_SAW, 			// 3 - Saw tooth |\|\|\.
	LFO_TRIANGLE,		// 4 - Saw tooth /\/\/\.
	LFO_SQUARE,			// 5 - Square |-|_|-|_|
	LFO_EXPDECREASE, 	// 6 - Decreasing exponential |\_
	LFO_EXPINCREASE, 	// 7 - Increasing exponential _/|
	LFO_EXTERNAL, 		// 8 - External signal ('pot')
	LFO_LEVEL, 			// 9 - Power amplitude of input signal
	LFO_REVERSE_LEVEL, 	// 10 - Reversed power amplitude of input signal
	LFO_LAST			// 11 - None
};

class LowFreqOsc
{
	public:
		LowFreqOsc() {}
		~LowFreqOsc() {}
		
		void 		Init(uint32_t sampling_rate);
		void 		SetPeriod(uint32_t prd);
		void 		SetFrequency(float freq);
		void 		SetDutyCycle(float duty_cycle);
		void 		SetProfile(uint8_t prof);
		void 		SetGain(uint32_t gain);
		uint32_t	GetAmplitude();
		uint32_t 	GetValue();
        void        Printout(int32_t chn_pos, char *printout);
		uint32_t 	sample_rate;	// sampling rate
		uint8_t   	profile;
        uint8_t     profiles_number     = PROFILES_NUMBER;  // number of profiles
		uint32_t  	period;  		// period of LFO in milliseconds
		float   	duty;     		// duty cycle (on) for some profiles, in percentile of period
		uint32_t 	max_gain; 		// LFO Amplitude
		
	private:
		uint32_t  	ampl_[512]; 	// lookup table (internal use)
		float     	phase_;   		// current phase (internal use)
		float     	rate_;			// phase angle increment
		uint32_t 	gain_;			// amplitude of LFO for LFO_EXTERNAL profile
									// or decay rate for exponential decay or inverse ED
		uint32_t 	duty_; 			// duty cycle in fraction of time lenght
};

#endif 	// GPS_LFO 	Low Frequency Oscillator
